fiuba-labo-de-micro-miercoles/2019-2c-proyecto-Cofimetro/README.md

Repositorio para la documentación de proyectos de
6609/8607 Laboratorio de Microcontroladores

Cabeza, Manuel 101627
Charrut, Matías -
Itzcovitz, Axel -

A decidir proyecto.
Proyecto (nombre) y breve descripción (3 párrafos)
