fiuba-labo-de-micro-miercoles/2019-2c-proyecto-Cofimetro/esquematico/kicad/report.txt

Información: Realizando copia de seguridad del archivo "C:\Users\gonza\Desktop\arduino_uno_r3_from_scratch-master\sym-lib-table" al archivo "C:\Users\gonza\Desktop\arduino_uno_r3_from_scratch-master\rescue-backup\sym-lib-table-2019-11-09-15-37-54".
Información: Realizando copia de seguridad del archivo "C:\Users\gonza\Desktop\arduino_uno_r3_from_scratch-master\Arduino_Uno_R3_From_Scratch.sch" al archivo "C:\Users\gonza\Desktop\arduino_uno_r3_from_scratch-master\rescue-backup\Arduino_Uno_R3_From_Scratch-2019-11-09-15-37-54.sch".
Información: Realizando copia de seguridad del archivo "C:\Users\gonza\Desktop\arduino_uno_r3_from_scratch-master\Voltage_Regulator.sch" al archivo "C:\Users\gonza\Desktop\arduino_uno_r3_from_scratch-master\rescue-backup\Voltage_Regulator-2019-11-09-15-37-54.sch".
Información: Realizando copia de seguridad del archivo "C:\Users\gonza\Desktop\arduino_uno_r3_from_scratch-master\voltage_management.sch" al archivo "C:\Users\gonza\Desktop\arduino_uno_r3_from_scratch-master\rescue-backup\voltage_management-2019-11-09-15-37-54.sch".
Información: Realizando copia de seguridad del archivo "C:\Users\gonza\Desktop\arduino_uno_r3_from_scratch-master\Pin_13_LED.sch" al archivo "C:\Users\gonza\Desktop\arduino_uno_r3_from_scratch-master\rescue-backup\Pin_13_LED-2019-11-09-15-37-54.sch".
Información: Realizando copia de seguridad del archivo "C:\Users\gonza\Desktop\arduino_uno_r3_from_scratch-master\USB_Interface.sch" al archivo "C:\Users\gonza\Desktop\arduino_uno_r3_from_scratch-master\rescue-backup\USB_Interface-2019-11-09-15-37-54.sch".
Información: Realizando copia de seguridad del archivo "C:\Users\gonza\Desktop\arduino_uno_r3_from_scratch-master\ATMEGA16U2.sch" al archivo "C:\Users\gonza\Desktop\arduino_uno_r3_from_scratch-master\rescue-backup\ATMEGA16U2-2019-11-09-15-37-54.sch".
Información: Realizando copia de seguridad del archivo "C:\Users\gonza\Desktop\arduino_uno_r3_from_scratch-master\Headers.sch" al archivo "C:\Users\gonza\Desktop\arduino_uno_r3_from_scratch-master\rescue-backup\Headers-2019-11-09-15-37-54.sch".
Información: Realizando copia de seguridad del archivo "C:\Users\gonza\Desktop\arduino_uno_r3_from_scratch-master\ATMEGA328P.sch" al archivo "C:\Users\gonza\Desktop\arduino_uno_r3_from_scratch-master\rescue-backup\ATMEGA328P-2019-11-09-15-37-54.sch".
Información: Realizando copia de seguridad del archivo "C:\Users\gonza\Desktop\arduino_uno_r3_from_scratch-master\Arduino_Uno_R3_From_Scratch.pro" al archivo "C:\Users\gonza\Desktop\arduino_uno_r3_from_scratch-master\rescue-backup\Arduino_Uno_R3_From_Scratch-2019-11-09-15-37-54.pro".
Información: Realizando copia de seguridad del archivo "C:\Users\gonza\Desktop\arduino_uno_r3_from_scratch-master\Arduino_Uno_R3_From_Scratch-cache.lib" al archivo "C:\Users\gonza\Desktop\arduino_uno_r3_from_scratch-master\rescue-backup\Arduino_Uno_R3_From_Scratch-cache-2019-11-09-15-37-54.lib".
Información: Realizando copia de seguridad del archivo "C:\Users\gonza\Desktop\arduino_uno_r3_from_scratch-master\Arduino_Uno_R3_From_Scratch-rescue.lib" al archivo "C:\Users\gonza\Desktop\arduino_uno_r3_from_scratch-master\rescue-backup\Arduino_Uno_R3_From_Scratch-rescue-2019-11-09-15-37-54.lib".
Información: Realizando copia de seguridad del archivo "C:\Users\gonza\Desktop\arduino_uno_r3_from_scratch-master\Arduino_Uno_R3_From_Scratch-rescue.dcm" al archivo "C:\Users\gonza\Desktop\arduino_uno_r3_from_scratch-master\rescue-backup\Arduino_Uno_R3_From_Scratch-rescue-2019-11-09-15-37-54.dcm".
Información: Añadiendo la librería "Arduino_Uno_R3_From_Scratch-rescue", archivo "${KIPRJMOD}/Arduino_Uno_R3_From_Scratch-rescue.lib" a la tabla de librerías de símbolos del projecto.
Información: Añadiendo la librería "Arduino_Uno_R3_From_Scratch", archivo "${KIPRJMOD}/Arduino_Uno_R3_From_Scratch.lib" a la tabla de librerías de símbolos del projecto.
Información: Añadiendo la librería "MFN_Atmel", archivo "${KIPRJMOD}/MFN_Atmel.lib" a la tabla de librerías de símbolos del projecto.
Información: Añadiendo la librería "MFN_STMicro", archivo "${KIPRJMOD}/MFN_STMicro.lib" a la tabla de librerías de símbolos del projecto.
El símbolo "D" está ligado a la librería de símbolos "Device".
El símbolo "CP" está ligado a la librería de símbolos "Device".
El símbolo "C" está ligado a la librería de símbolos "Device".
El símbolo "BARREL_JACK" está ligado a la librería de símbolos "Arduino_Uno_R3_From_Scratch-rescue".
El símbolo "CP" está ligado a la librería de símbolos "Device".
El símbolo "R" está ligado a la librería de símbolos "Device".
El símbolo "LED" está ligado a la librería de símbolos "Arduino_Uno_R3_From_Scratch-rescue".
El símbolo "Vin" está ligado a la librería de símbolos "Arduino_Uno_R3_From_Scratch".
El símbolo "5V_LDO" está ligado a la librería de símbolos "Arduino_Uno_R3_From_Scratch".
El símbolo "5V_LDO" está ligado a la librería de símbolos "Arduino_Uno_R3_From_Scratch".
El símbolo "GND" está ligado a la librería de símbolos "power".
El símbolo "LD1117S50TR" está ligado a la librería de símbolos "Arduino_Uno_R3_From_Scratch-rescue".
El símbolo "GND" está ligado a la librería de símbolos "power".
El símbolo "GND" está ligado a la librería de símbolos "power".
El símbolo "GND" está ligado a la librería de símbolos "power".
El símbolo "GND" está ligado a la librería de símbolos "power".
El símbolo "GND" está ligado a la librería de símbolos "power".
El símbolo "R" está ligado a la librería de símbolos "Device".
El símbolo "Q_PMOS_GSD" está ligado a la librería de símbolos "Device".
El símbolo "LM358" está ligado a la librería de símbolos "Arduino_Uno_R3_From_Scratch-rescue".
El símbolo "GND" está ligado a la librería de símbolos "power".
El símbolo "GND-RESCUE-Arduino_Uno_R3_From_Scratch" está ligado a la librería de símbolos "Arduino_Uno_R3_From_Scratch-rescue".
El símbolo "USBVCC" está ligado a la librería de símbolos "Arduino_Uno_R3_From_Scratch".
El símbolo "LP2985LV" está ligado a la librería de símbolos "Arduino_Uno_R3_From_Scratch-rescue".
El símbolo "C" está ligado a la librería de símbolos "Device".
El símbolo "C" está ligado a la librería de símbolos "Device".
El símbolo "R" está ligado a la librería de símbolos "Device".
El símbolo "C" está ligado a la librería de símbolos "Device".
El símbolo "3V3_LDO" está ligado a la librería de símbolos "Arduino_Uno_R3_From_Scratch".
El símbolo "5V_LDO" está ligado a la librería de símbolos "Arduino_Uno_R3_From_Scratch".
El símbolo "5V_LDO" está ligado a la librería de símbolos "Arduino_Uno_R3_From_Scratch".
El símbolo "Vin" está ligado a la librería de símbolos "Arduino_Uno_R3_From_Scratch".
El símbolo "3V3_LDO" está ligado a la librería de símbolos "Arduino_Uno_R3_From_Scratch".
El símbolo "GND" está ligado a la librería de símbolos "power".
El símbolo "GND" está ligado a la librería de símbolos "power".
El símbolo "GND" está ligado a la librería de símbolos "power".
El símbolo "GND" está ligado a la librería de símbolos "power".
El símbolo "GND" está ligado a la librería de símbolos "power".
El símbolo "LM358" está ligado a la librería de símbolos "Arduino_Uno_R3_From_Scratch-rescue".
El símbolo "LED" está ligado a la librería de símbolos "Arduino_Uno_R3_From_Scratch-rescue".
El símbolo "R" está ligado a la librería de símbolos "Device".
El símbolo "5V_LDO" está ligado a la librería de símbolos "Arduino_Uno_R3_From_Scratch".
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
El símbolo "C" está ligado a la librería de símbolos "Device".
El símbolo "R" está ligado a la librería de símbolos "Device".
El símbolo "R" está ligado a la librería de símbolos "Device".
El símbolo "R" está ligado a la librería de símbolos "Device".
El símbolo "C" está ligado a la librería de símbolos "Device".
El símbolo "R" está ligado a la librería de símbolos "Device".
El símbolo "GND" está ligado a la librería de símbolos "power".
El símbolo "GND" está ligado a la librería de símbolos "power".
El símbolo "GND" está ligado a la librería de símbolos "power".
El símbolo "GND" está ligado a la librería de símbolos "power".
El símbolo "GND" está ligado a la librería de símbolos "power".
Información: ¡Se ha completado el mapeado de la tabla de librerías de símbolos!
