fiuba-labo-de-micro-miercoles/2019-2c-proyecto-Cofimetro/doc/informe/Informe_Coff.pdf

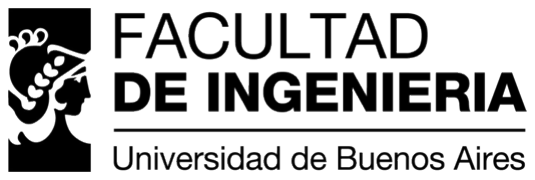
[picture p1: figure]

## Laboratorio de Microcomputadoras - 86.09

# Cofímetro

Profesor: | Ing. Guillermo Campiglio
Cuatrimestre/Año: | 2 o/2019
Turno de las clases prácticas | Miércoles 19-22 hs
Jefe de trabajos prácticos: | Ricardo Arias
Docente guía: | Ricardo Arias
Autores | Seguimiento del proyecto
Nombre | Apellido | Padron
Manuel | Cabeza | 101627
Axel | Itzcovitz | 100742
Matías | Charrut | 101137

### Observaciones:

Fecha de aprobación | Firma J.T.P

### Coloquio Nota final Firma profesor

# Índice

1. Objetivos | 1
2. Descripción del proyecto | 1
3. Diagrama de bloques | 1
4. Circuito esquemático | 1
5. Listado de componentes | 2
6. Software | 4
7. Resultados | 7
8. Conclusiones | 8
9. Apéndice I (Circuito Completo) | 8
10.Apéndice II (Código) | 18
11.Apéndice III: Presupuesto del proyecto | 35

# 1. Objetivos

El objetivo del proyecto es presentar en un display la tensión, corriente y desfasaje de un dispositivo conectado a la linea.

# 2. Descripción del proyecto

El proyecto consiste en un bloque medidor, que se encarga de obtener la información de tensión y corriente del circuito conectado a la tensión de línea, así como de adaptar estos valores de tal forma de poder ser procesados por el microcontrolador. Con esta información recibida, este último irá recolectando los valores de tensión y corriente para obtener un valor RMS de cada uno, así como también analiza cada una de las señales por medio de los muestreos adaptados que se le ingresan para calcular el desfasaje que hay entre ambas señales, para así obtener el cos(ϕ) del dispositivo. Luego, se imprimen los valores obtenidos (tensión, corriente y cos(ϕ)) utilizando un display LCD.

# 3. Diagrama de bloques

Figura 1: Diagrama de bloques.

El circuito funciona a partir de la tensión de linea para medir la corriente, tensión y el desfasaje. La medición de corriente se realiza mediante el sensor ASC-712 y la de tensión mediante un circuito realizado especialmente. El desfasaje se obtiene haciendo uso del comparador interno del microcontrolador y de un comparador externo. Estos tres parámetros son dispuestos en el display.

# 4. Circuito esquemático

El circuito completo se encuentra en el apéndice I. En esta sección se describe el circuito realizado para la medición de tensión y el sensor utilizado para la medición de corriente (ACS-712).

## 4.1. Medición de tensión

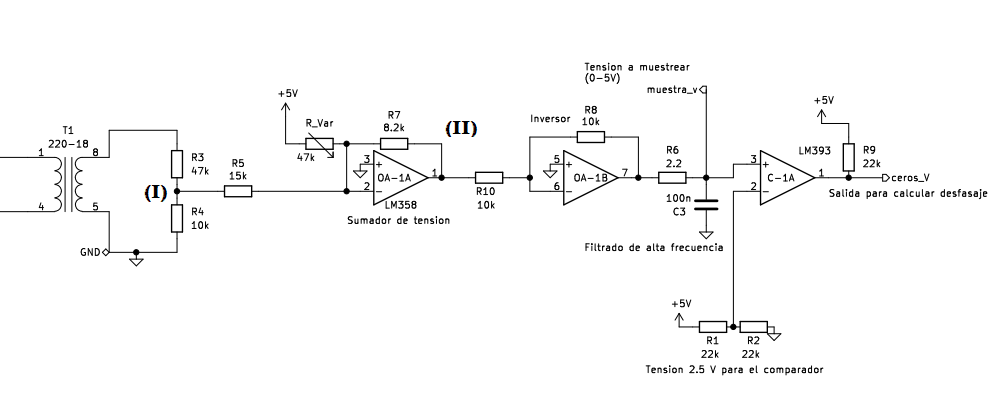
[picture p2: figure]

Figura 2: Esquema del circuito para medir tensión.

El circuito busca obtener una muestra de tensión proporcional a la de entrada que tome valores entre 0 y 5 V y una señal cuadrada que tome valores ’1’ cuando la entrada se encuentra en el semiciclo positivo y ’0’ cuando está en el semiciclo negativo. El mismo se conecta en paralelo con el dispositivo al cual se le va a medir la corriente.
Para esto se comienza con un transformador que baja el valor eficaz de la señal en un factor de aproximadamente 12.22. Esa señal pasa por un divisor resistivo para que la entrada al sumador oscile con un valor pico de 2.5 V (nodo I). La otra entrada del sumador proviene de los 5 V. A partir de los valores de resistencias R5
- R7 se modifica el preset de 47 k para obtener en el nodo II una señal que oscila alrededor de 2,5 V con un valor pico de aproximadamente 2,5 V a una entrada de 220 Vef . Esta señal pasa por un inversor para obtener la señal que se busca entre 0 y 5 V, esa pasa por un filtro RC de una alta frecuencia de corte para disminuir el ruido. A la salida del filtro se toma la señal muestra_v que va al ADC del microcontrolador. La misma va además al terminal inversor del comparador, que tiene su terminal positivo conectado a una señal continua de 2,5 V. Así a la salida del comparador se tiene la señal ceros_v que se utiliza para calcular el desfasaje. A la salida del comparador se utilizó una resistencia de Pull-Up.
Así se obtiene una señal en muestra_v cuyo valor eficaz se relaciona con el valor eficaz de la señal de entrada de forma lineal a través de la constante 91,3 (la obtención de la constante de proporcionalidad fue de forma experimental.).

## 4.2. Medición de corriente

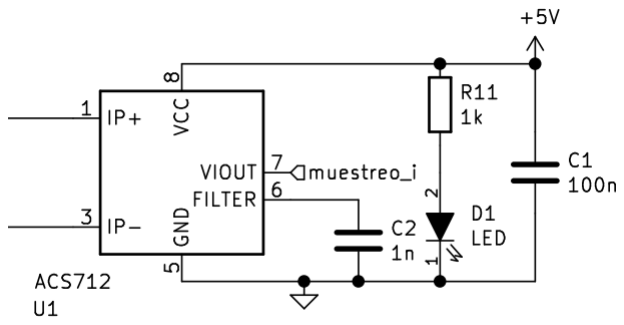
[picture p3: figure]

Figura 3: Esquema del circuito para medir corriente.

Para la medición de corriente se utilizó el circuito de la figura anterior conectado en serie con el vivo de la tensión de línea (ver Anexo I), el mismo asegura una variación lineal de tensión de salida según la corriente de entrada dada por la siguiente formula en el terminal muestreo_i, siempre que el valor de la corriente pico sea menor a 5A.

### VOUT = 2, 5V + I 0, 2

V
A
Como se alimenta con VCC = 5 V, la señal de salida varía entre 0,5 y 5 V. Ésta se conecta con el terminal del ADC del microcontrolador.

# 5. Listado de componentes

### Display LCD 16x2

### Sensor de efecto Hall ACS712 ± 5A

### Comparador LM393

### Arduino UNO

### Amplificador Operacional LM358

### Transformador 220V-18V

### Tomacorriente 220V

### Enchufe 220V

### 2 Presets 100 KΩ

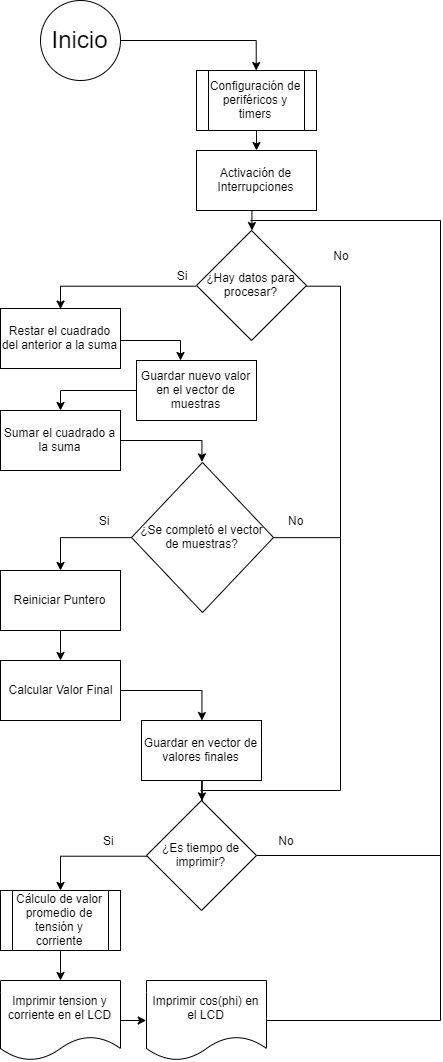
[picture p4: figure]

### Figura 4: Diagrama de flujo del programa principal

# 6. Software

El programa principal comienza con la configuración del LCD, el ADC, el timer0, el timer1 y las interrupciones. Luego, comienza el ciclo infinito del main, el cual verifica todo el tiempo si hay datos para procesar, además de vigilar si es momento de imprimir datos en el LCD. Son cuatro las distintas interrupciones del programa: el

### overflow del timer0, la cual enciende la conversión del ADC¹

, la producida cuando el ADC termina de convertir, y las de cambio de estado en el pin D5 y en el comparador. Tanto la medición de tensión como la de corriente se realizan cada 39 µs , de manera tal que se muestreen 256 veces cada una en cada ciclo (50 Hz).

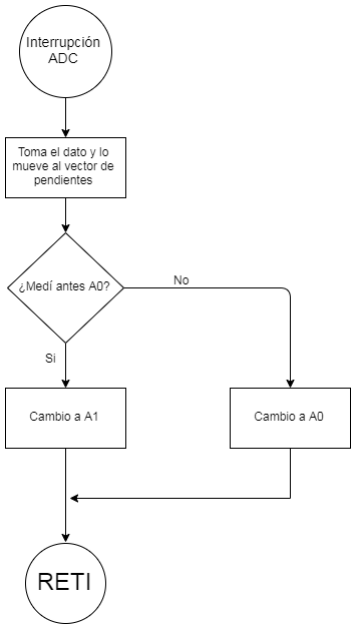
[picture p5: figure]

### Figura 5: Diagrama de flujo de la interrupción por ADC

1El timer0 también suma al contador que maneja la impresión, lo cual está ajustado para que imprima cada aproximadamente 1 segundo.

### Figura 6: Diagrama de flujo de la interrupción por Timer 0

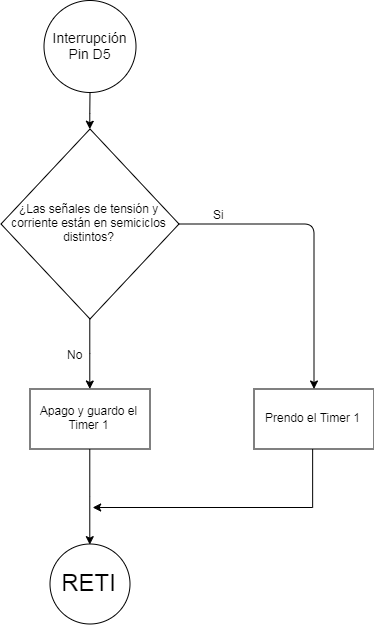
[picture p6: figure]
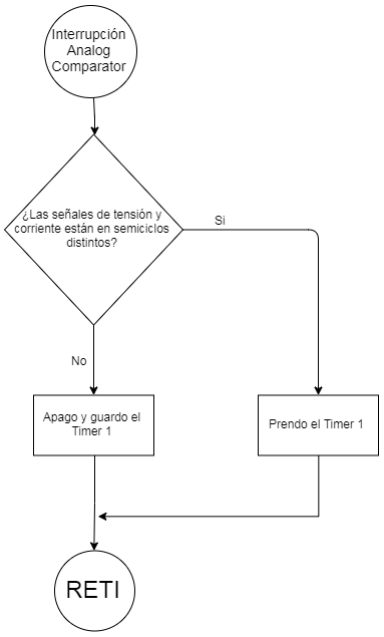
[picture p7: figure]

(a) Interrupción por el pin D5 | (b) Interrupción por el comparador analógico

### Figura 7: Diagramas de flujo de las interrupciones para el desfasaje

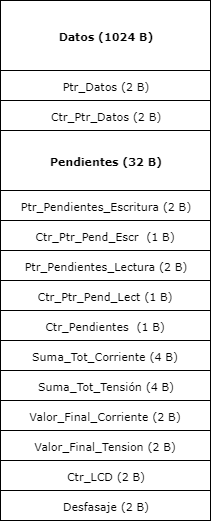
[picture p8: figure]

### Figura 8: Mapa de Memoria RAM

## 6.1. Medición de tensión y corriente

La tensión se mide por el pin A0 y la corriente por el pin A1. El proceso de medición es similar en ambos casos. Dado que el ADC es de 10 bits, a partir de lo que se mida se obtendrá un valor entre 0 y 1023. Cada vez que se mida, la interrupción del ADC guardará el valor en un vector de pendientes (cuando se llena comienza a pisar valores) y suma a un contador. El programa principal vigila este contador y cuando detecta que hay un valor pendiente, lo procesa: calcula el cuadrado del valor anterior a éste (es decir, el valor que se guardó hace 256 muestras) y se lo resta a la suma total de los cuadrados. Después, guarda el valor nuevo en el vector, le calcula el cuadrado y se lo suma al total. Cuando detecta que se llenó el vector (es decir, que llegó a la posición
256) reinicia el puntero del vector (es decir, vuelve al principio) y calcula el valor final RMS de la tensión (o la

### corriente), de modo que

### XRMS =

sP256
i=1 x

2
i
N

Este valor es guardado en un vector con los últimos 32 calculados para luego ser promediado al momento de imprimir, de modo que se pueda reducir el ruido introducido al momento de la medición. Para la impresión, este valor se usa para entrar en la tabla correspondiente (tensión o corriente), la cual lo convierte al valor real que va a ser impreso.

## 6.2. Medición de desfasaje

Para la medición del desfasaje, se busca obtener la diferencia de tiempo entre el cruce por cero de tensión y el cruce por cero de corriente. Para ello, primeramente se obtiene una señal cuadrada de cada una, tal que la misma valga ’1’ lógico para cuando se encuentra en el semiciclo positivo, y ’0’ lógico para cuando se encuentra en el semiciclo negativo. En el caso de la tensión, esta señal cuadrada valdrá ’1’ para los valores de tensión positivos, mientras que para la corriente, dado que la señal que sale del ACS712 se encuentra montada sobre una tensión continua de 2.5V, la señal valdrá ’1’ para valores de tensión mayores a esta continua sobre la que está montada. Para la obtención de la señal cuadrada de tensión, se utiliza el comparador LM393, el cual compara la señal de tensión con 2.5V, dado que la señal que obtenemos de la línea es amplificada para luego agregarle la continua de comparación, obteniendo la salida en el pin digital 5 (PD5), mientras que para la señal cuadrada de corriente se utiliza el comparador interno analógico del microcontrolador, realizando también la comparación con 2.5V, obteniendo la salida en el analog-comparator-output (ACO). Cada vez que cambia el pin 5 o la salida del comparador del microcontrolador salta una interrupción, la cual realiza una XOR entre los dos valores. Si los dos son un ’1’ o los dos son un ’0’, se apaga el timer1 y se guarda su valor. Si los valores son diferentes, se reinicia el timer1 y se prende. El preescaler se configuró de manera que sea posible medir 10ms, que es el máximo desfasaje posible que puede existir en una señal de línea. Para la impresión, este valor se usa para entrar en una tabla, la cual lo convierte al valor real que va a ser impreso.

# 7. Resultados

Una vez ensamblados hardware y software, los resultados iniciales fueron muy desalentadores, dado que no se conseguía estabilizar los valores a obtener, además de que los valores obtenidos no eran los correctos (según los valores de tensión de línea y corriente medidos con un multímetro ). Así, se encontraron múltiples diferencias entre nuestra estimación de lo que sería el circuito con lo que finalmente era, como que la tensión continua del ACS712 no era exactamente 2.5V o que la frecuencia de la tensión de línea no coincidía con nuestra tensión de muestreo del microcontrolador. Por lo tanto, se debió realizar una calibración del circuito, para así ajustar nuestros cálculos iniciales a los valores reales de cada componente.
La calibración se realizó tomando muestras de los valores a la entrada y la salida del circuito y, dado que la relación entre los mismos varía como una raíz cuadrada al ser valores eficaces, se elevaron al cuadrado los resultados para levarla a una relación lineal y poder hacer cuadrados mínimos. Así se obtuvo una calibración final que lleva a una mejor aproximación de las mediciones que la original.
Para poder medir el cos(ϕ) se debió realizar un circuito aparte que genere un desfasaje entre dos señales, debido a que para medir un cos(ϕ) distinto de 1 se debía utilizar un instrumento altamente inductivo, como un motor, el cual resultaba impráctico para realizar la medición. Para el mismo se utilizó el circuito en la figura 9, con el cual utilizando un preset entre la entrada V1 y el borne positivo del operacional se pudo regular un cos(ϕ) entre 0 y 1, para así verificar el correcto funcionamiento del medidor a lo largo de todos los valores.

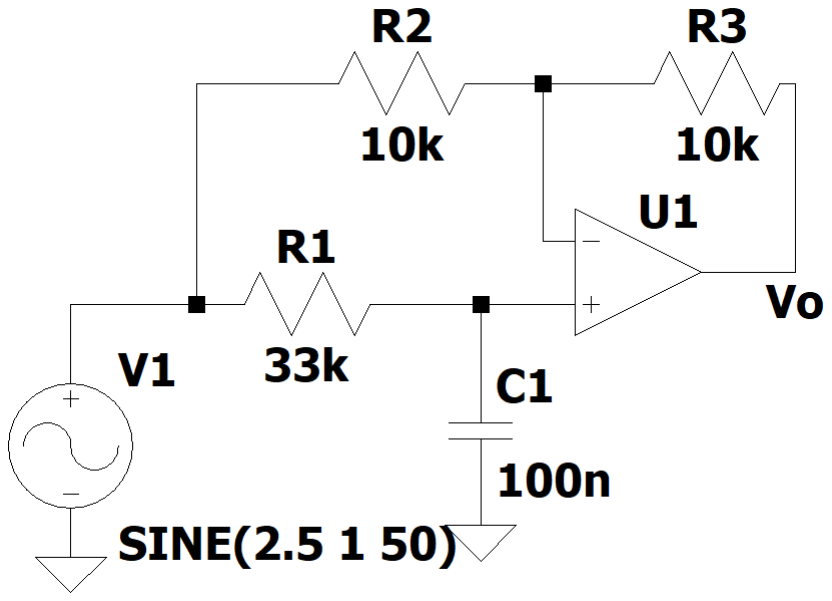
[picture p9: figure]

### Figura 9: Circuito utilizado para la medición del cos(ϕ)

Sobre la precisión final del las mediciones, en el caso de la tensión se debió mapear un valor eficaz a la entrada que iba desde 0 V hasta como máximo 250 V a una variación de valor eficaz a la salida de 0.56 V (como máximo). Debido a esto la incerteza final de las mediciones no se pudo reducir demasiado y de los 10 bits que se utilizaron para realizar la medición, es decir una tabla de 1024 posiciones, solo fueron utilizables 114 entradas. Algo análogo sucedió para la corriente, donde el valor eficaz máximo obtenible limitado por el sensor es de 3,57 A. A la salida también se obtiene una señal con una variación de valor eficaz menor a 0,56 V reduciendo el número efectivo de entradas a las tablas de mediciones y empeorando la incerteza de las mediciones.

# 8. Conclusiones

Una de las principales conclusiones que se obtuvieron a partir de la realización del proyecto es la importancia de la correcta obtención de los valores con los que se realizan los cálculos previos a las mediciones y la correcta caracterización de los periféricos, ya que por ejemplo, según los cálculos del amplificador para la tensión, la continua que agregaba era de 2,5 V, pero la que se agregaba realmente era de 2,4 V, y esto alteraba las mediciones. Estas diferencias entre la teoría y la práctica llevaron a que se obtuvieran serias diferencias entre los valores que debíamos obtener y los obtenidos, dada la sensibilidad que manejaba este circuito con respecto a estos valores.
Por último, la experiencia de realizar un proyecto cuya función principal fuese la medición resultó un tanto conflictiva, debido a la cantidad de componentes que requiere el mismo, aumentando así la posibilidad de obtener mediciones erróneas o inestables ante la pequeña falla de alguno de estos, como un pequeño desafloje de los pines o los cables, un pequeño desajuste en la frecuencia de muestreo, o una ligera diferencia entre una constante teórica y real.

# 9. Apéndice I (Circuito Completo)

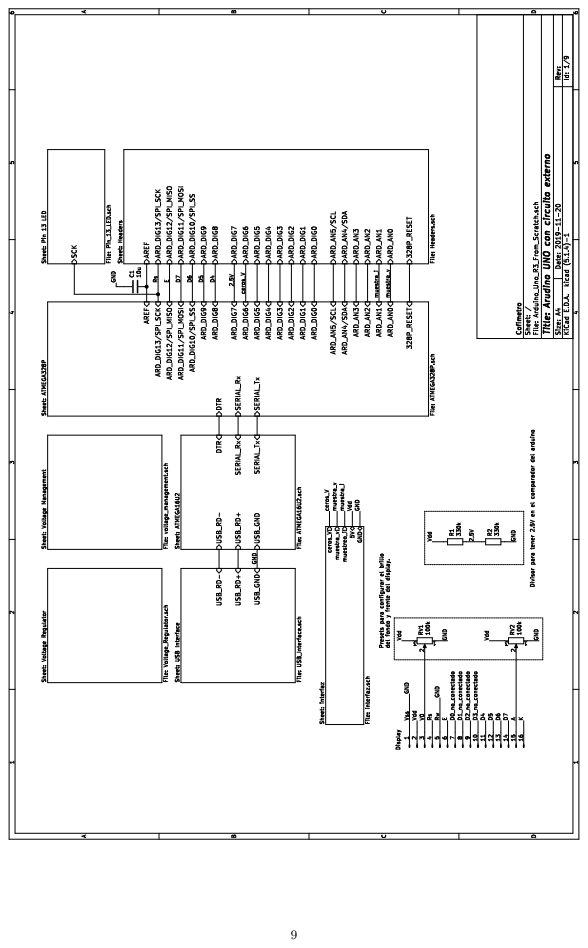
[picture p10: page 11]

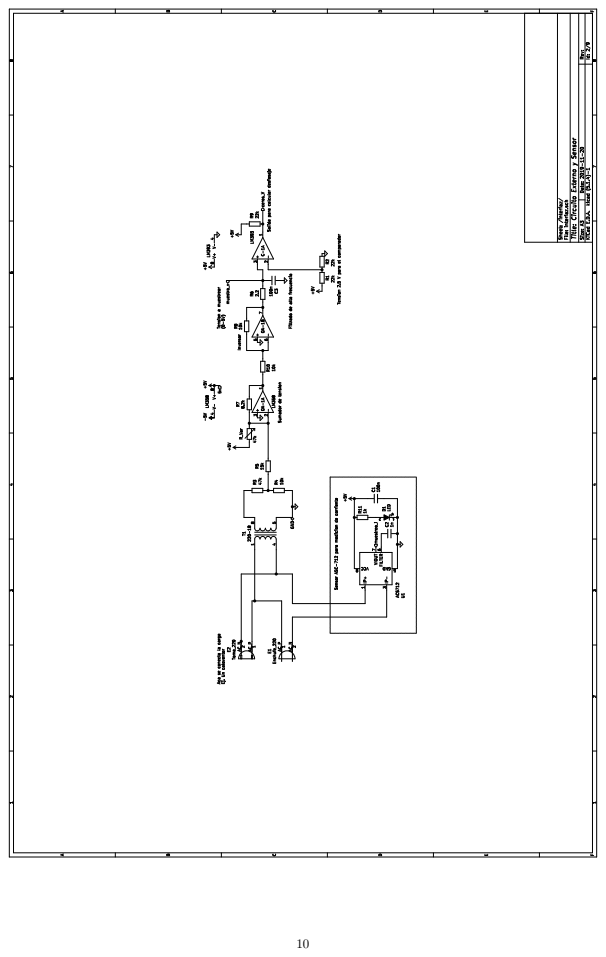
[picture p11: page 12]

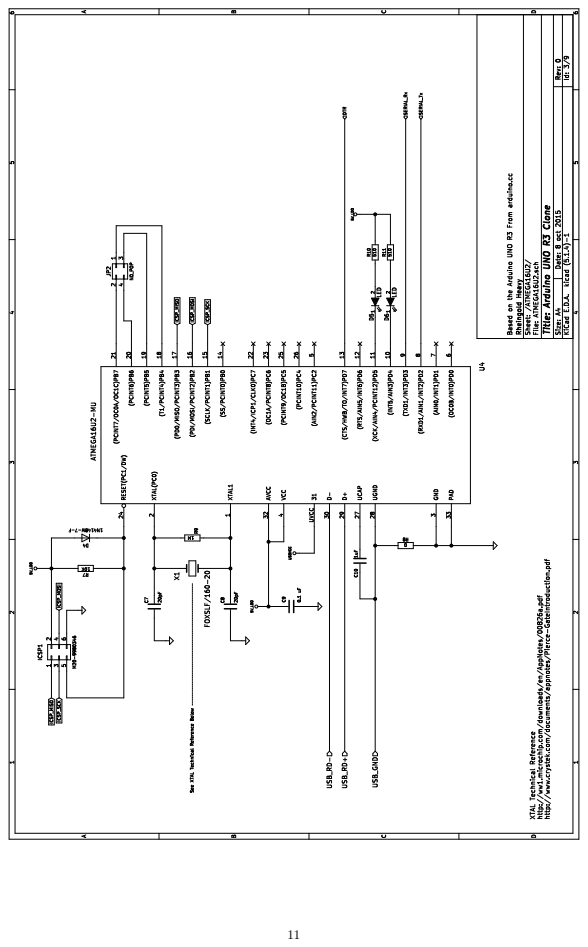
[picture p12: page 13]

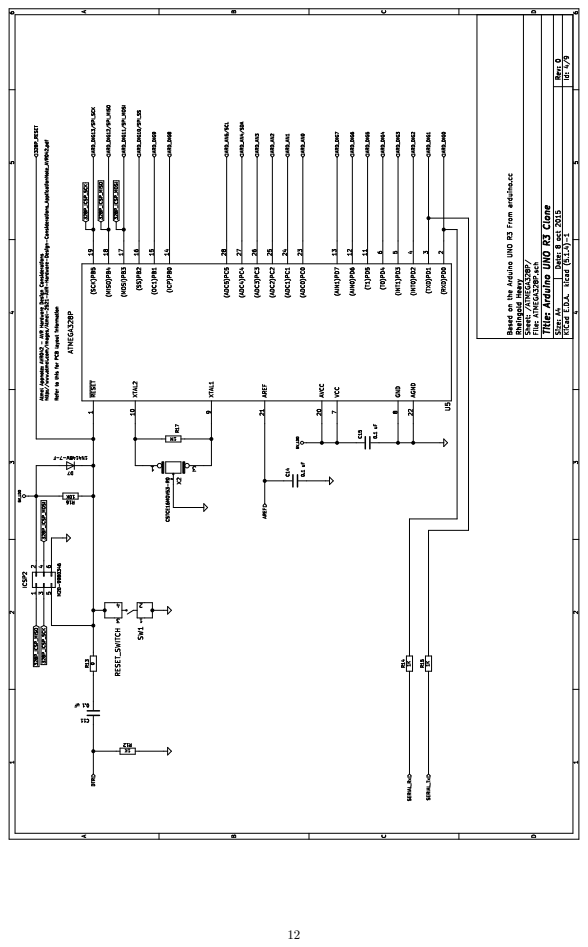
[picture p13: page 14]

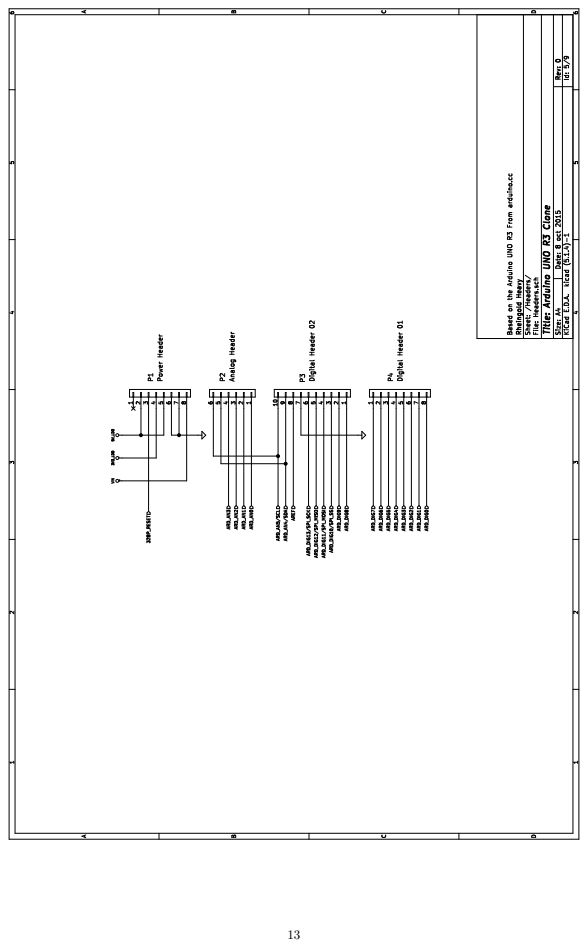
[picture p14: page 15]

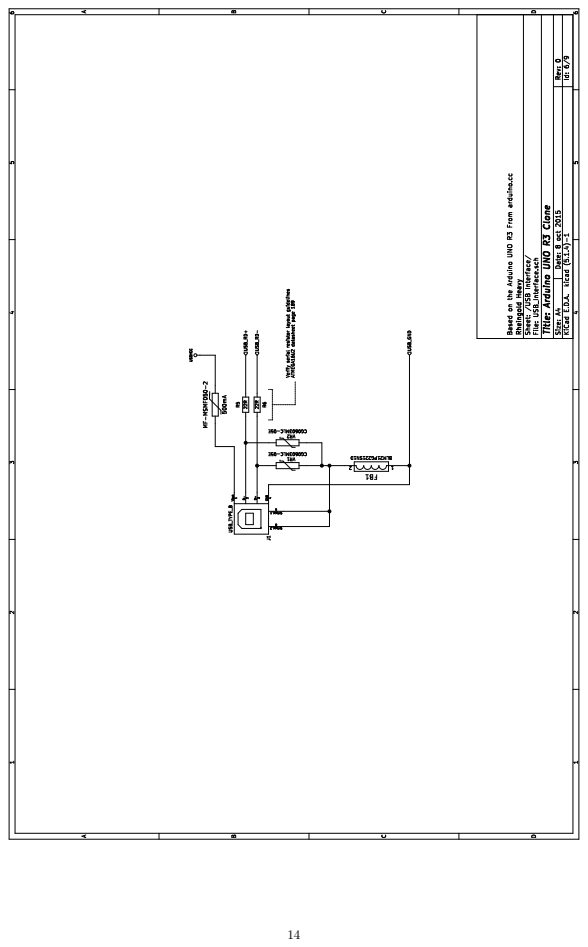
[picture p15: page 16]

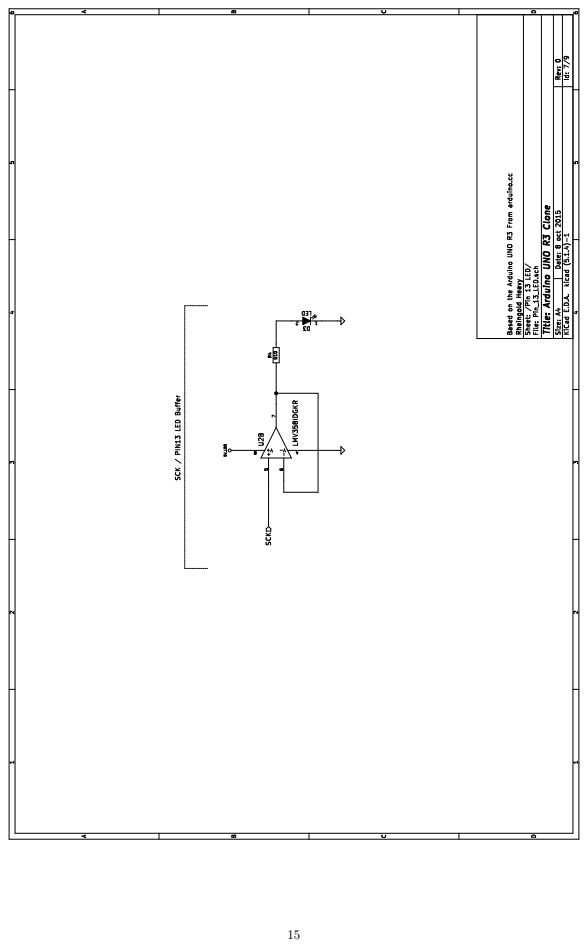
[picture p16: page 17]

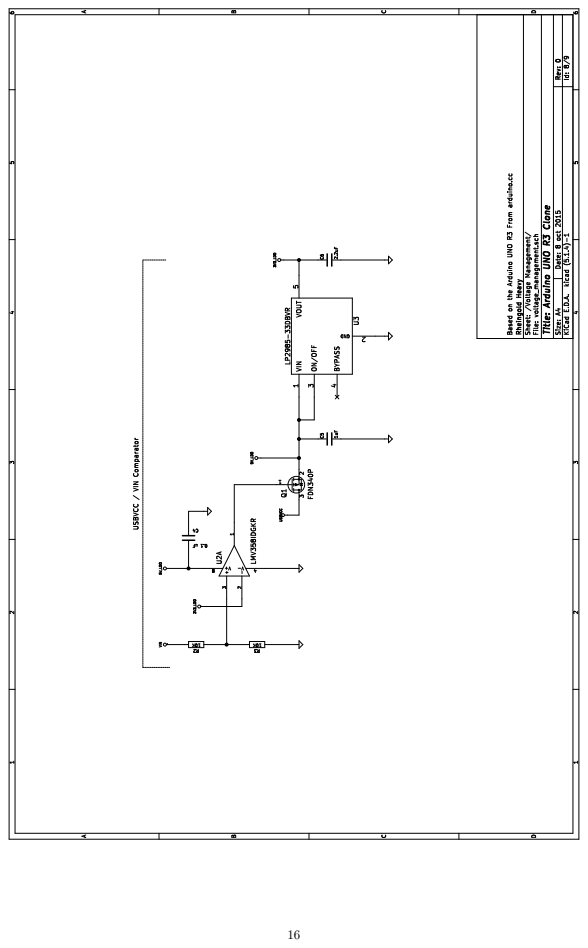
[picture p17: page 18]

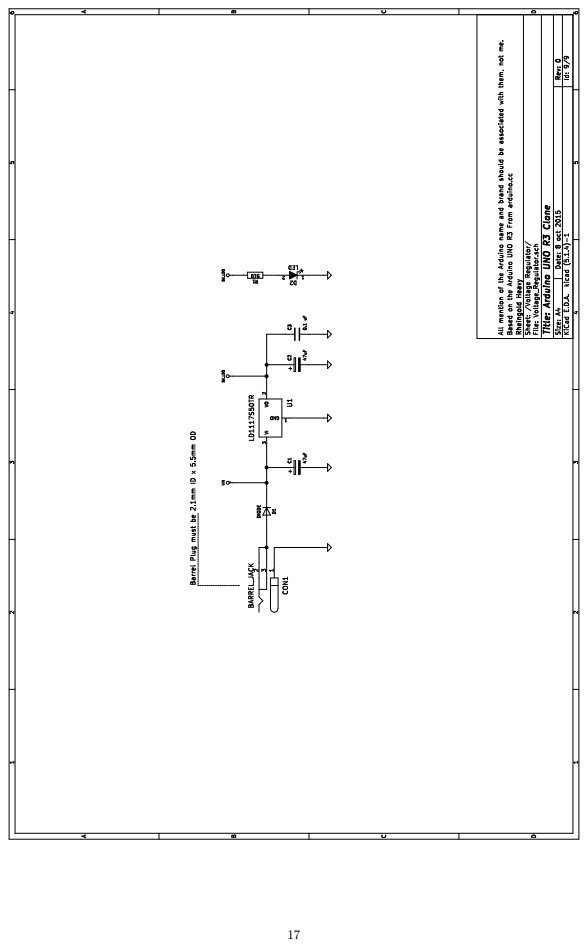
[picture p18: page 19]

# 10. Apéndice II (Código)

1 | ; f i l e : main . asm
2 | . i n cl u d e "m328pdef . i n c "
3 | ; F r e c u e n ci a 16MHz

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

20
21 | ENTER_WRITE_ROM:
22 | MOVE_TO NEXT_LINE
23 | LDI R21 , 15
24 | RJMP FOR_WRITE_ROM

25
26 | END_WRITE_ROM:
27 | ; te rmin a l a macro
28 | .ENDM

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

35

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

55

56
57 CTR_LCD: .BYTE 2 ; c on t ad o r de tiempo de r e f r e s c o de l c d

58
59 DESFASAJE: .BYTE 1 ; v al o r de d e s f a s a j e

60
61 | .CSEG
62 | ; v e c t o r e s de i n t e r r u p c i o n
63 | .ORG 0 x0000
64 | RJMP MAIN
65 | .ORG PCI2addr
66 | RJMP HANDLER_XOR
67 | .ORG OVF0addr
68 | RJMP HANDLER_TIMER0
69 | .ORG ADCCaddr
70 | RJMP HANDLER_ADC
71 | .ORG ACIaddr
72 | RJMP HANDLER_XOR

74 .ORG INT_VECTORS_SIZE

75

76
77 | MAIN:
78 | ; i n i c i a l i z o e l s t a c k
79 | LDI R16 , LOW(RAMEND)
80 | OUT SPL, R16
81 | LDI R16 , HIGH(RAMEND)
82 | OUT SPH, R16

83
84 | CALL CONFIGURATION_LCD
85 | CALL CONFIGURAR_ADC

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

91

92
93 | CALL INICIALIZAR_SUMAS

94
95 | CALL INICIALIZAR_PTR_DATOS

96
97 | CALL INICIALIZAR_PUNTERO_PENDIENTES_LECTURA

98
99 | CALL INICIALIZAR_PUNTERO_VALOR_FINAL

100
101 | CLR R16
102 | STS CTR_PENDIENTES, R16

103
104 | ; c o n fi g u r o d e s f a s a j e
105 | CALL CONFIGURAR_DESFASAJE

106
107 | ; lim pi o l c d e imprimo e l t e x t o (V, I , c o s ( phi ) )
108 | CALL CLEAN
109 | CALL TEXTO_LCD

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

113

114

115
116 | HERE: ; c i c l o i n f i n i t o de v e r i f i c a r s i hay p e n di e n t e s para p r o c e s a r e imp rimi r
117 | LDS R16 , CTR_PENDIENTES
118 | CLR R0
119 | CPSE R16 , R0
120 | CALL PROCESAR
121 | LDS R16 , CTR_LCD + 1
122 | SBRC R16 , 7
123 | CALL IMPRIMIR_TODO
124 | RJMP HERE

125

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

137

138
139 | ; t e x t o para imp rimi r .
140 | TEX_TENSION: .DB "V=", ’ \ 0 ’
141 | TEX_CORRIENTE: .DB " I =", ’ \ 0 ’
142 | TEX_COSFI: .DB " c o s ( phi ) =", ’ \ 0 ’

### codigo/main.asm

[U+FFFD] 1 | ; f i l e : r aiz_cu ad r ad a . asm

2
3 . i n cl u d e "m328pdef . i n c "

5 | .DEF CUADRADO_4toBYTE = R2
6 | .DEF CUADRADO_3erBYTE = R3
7 | .DEF CUADRADO_2doBYTE = R4
8 | .DEF CUADRADO_1erBYTE = R5
9 | .DEF RESTO_4 = R6
10 | .DEF RESTO_3 = R7
11 | .DEF RESTO_2 = R8
12 | .DEF RESTO_1 = R9
13 | .DEF CONT_RL = R10
14 | .DEF CONT_ITERACIONES = R11
15 | .DEF DIVIS_4 = R12
16 | .DEF DIVIS_3 = R13
17 | .DEF DIVIS_2 = R14
18 | .DEF DIVIS_1 = R15
19 | .DEF TEMP = R16
20 | .DEF INIT_CUADRADO_4toBYTE = R18
21 | .DEF INIT_CUADRADO_3erBYTE = R19
22 | .DEF INIT_CUADRADO_2doBYTE = R20
23 | .DEF INIT_CUADRADO_1erBYTE = R21
24 | .DEF RESUL_4 = R22
25 | .DEF RESUL_3 = R23
26 | .DEF RESUL_2 = R24
27 | .DEF RESUL_1 = R25
28 | .DEF DIVID_4 = R22
29 | .DEF DIVID_3 = R23
30 | .DEF DIVID_2 = R24
31 | .DEF DIVID_1 = R25

32

33
34 | .EQU CANT_ITERACIONES = 6
35 | .EQU FALTA_RESTA_4toBYTE = 2
36 | .EQU FALTA_RESTA_3erBYTE = 1
37 | .EQU FALTA_RESTA_2doBYTE = 0

38

39
40 | ; s e l e pasan v a l o r e s de sde R5(LSB) h a s t a R2(MSB) , y d e v u el v e l a r a i z en R21 (LSB) y en R20 (MSB)
41 | RAIZ_CUADRADA:
42 | ; s e lim pi a n t od o s l o s r e g i s t r o s que s e vayan a u s a r
43 | CLR RESTO_4
44 | CLR RESTO_3
45 | CLR RESTO_2
46 | CLR RESTO_1
47 | CLR CONT_RL
48 | CLR CONT_ITERACIONES
49 | CLR DIVIS_4
50 | CLR DIVIS_3
51 | CLR DIVIS_2
52 | CLR DIVIS_1
53 | CLR TEMP
54 | CLR INIT_CUADRADO_4toBYTE
55 | CLR INIT_CUADRADO_3erBYTE
56 | CLR INIT_CUADRADO_2doBYTE
57 | CLR INIT_CUADRADO_1erBYTE
58 | CLR RESUL_4
59 | CLR RESUL_3
60 | CLR RESUL_2
61 | CLR RESUL_1
62 | CLR DIVID_4
63 | CLR DIVID_3
64 | CLR DIVID_2
65 | CLR DIVID_1
66 | LDI TEMP,CANT_ITERACIONES
67 | MOV CONT_ITERACIONES,TEMP;CARGO LA CANTIDAD DE ITERACIONES

68
69 | ; s i e l numero que s e i n g r e s a para h a c e r l a r a i z cuadrada e s 0 , di r e c t am e n t e s e d e v u el v e 0
70 | ; para e v i t a r h a c e r d i v i s i o n e s por 0 .
71 | VERIFICAR_CERO:
72 | CLR TEMP
73 | CP CUADRADO_1erBYTE, TEMP
74 | BRNE INICIALIZAR_RAIZ
75 | CP CUADRADO_2doBYTE, TEMP
76 | BRNE INICIALIZAR_RAIZ
77 | CP CUADRADO_3erBYTE, TEMP
78 | BRNE INICIALIZAR_RAIZ
79 | CP CUADRADO_4toBYTE, TEMP
80 | BRNE INICIALIZAR_RAIZ

81 | RET

82
83 | ; INICIALIZO LA SEMILLA SEGUN EL TAMAÑO DEL NUMERO QUE ENTRA
84 | INICIALIZAR_RAIZ :
85 | CLR INIT_CUADRADO_4toBYTE
86 | CLR INIT_CUADRADO_3erBYTE
87 | LDI INIT_CUADRADO_2doBYTE, 0 xFF
88 | LDI INIT_CUADRADO_1erBYTE, 0 xFF
89 | VER_4toBYTE:
90 | CLR TEMP
91 | CP CUADRADO_4toBYTE,TEMP
92 | BRNE VER_3erBYTE
93 | ANDI INIT_CUADRADO_2doBYTE, 0 xF0
94 | VER_3erBYTE:
95 | CP CUADRADO_3erBYTE,TEMP
96 | BRNE VER_2doBYTE
97 | ANDI INIT_CUADRADO_2doBYTE, 0 x0F
98 | VER_2doBYTE:
99 | CP CUADRADO_2doBYTE,TEMP
100 | BRNE VER_1erBYTE
101 | ANDI INIT_CUADRADO_1erBYTE, 0 xF0
102 | VER_1erBYTE:
103 | CP CUADRADO_1erBYTE,TEMP
104 | BRNE ITERACION_RAIZ
105 | ANDI INIT_CUADRADO_1erBYTE, 0 x0F
106 | ; [ FIN ] INICIALIZO LA SEMILLA SEGUN EL TAMAÑO DEL NUMERO QUE ENTRA

107

108
109 | ; i t e r a c i o n de newton−raphson
110 | ITERACION_RAIZ:
111 | CALL RAIZ_NR
112 | DEC CONT_ITERACIONES
113 | BRNE ITERACION_RAIZ
114 | RET

115
116 | ; e j e c u t a una i t e r a c i o n de newton−raphson
117 | RAIZ_NR:
118 | ; a
119 | MOVW DIVID_3 : DIVID_4 ,CUADRADO_3erBYTE:CUADRADO_4toBYTE
120 | MOVW DIVID_1 : DIVID_2 ,CUADRADO_1erBYTE:CUADRADO_2doBYTE
121 | ; [ FIN ] a
122 | ;X( k )
123 | MOVW DIVIS_3 : DIVIS_4 , INIT_CUADRADO_3erBYTE: INIT_CUADRADO_4toBYTE
124 | MOVW DIVIS_1 : DIVIS_2 , INIT_CUADRADO_1erBYTE:INIT_CUADRADO_2doBYTE
125 | ; [ FIN ]X( k )
126 | CALL DIVISION ; a /X( k )
127 | ;X( k ) + a/X( k )
128 | ADD INIT_CUADRADO_1erBYTE,RESUL_1
129 | ADC INIT_CUADRADO_2doBYTE,RESUL_2
130 | ADC INIT_CUADRADO_3erBYTE,RESUL_3
131 | ADC INIT_CUADRADO_4toBYTE,RESUL_4
132 | ; [ FIN ]X( k ) + a/X( k )
133 | ; (X( k ) + a/X( k ) ) /2
134 | LSR INIT_CUADRADO_4toBYTE
135 | ROR INIT_CUADRADO_3erBYTE
136 | ROR INIT_CUADRADO_2doBYTE
137 | ROR INIT_CUADRADO_1erBYTE
138 | ; [ FIN ] (X( k ) + a/X( k ) ) /2
139 | RET

140
141 | ; di vi d e mediante e l metodo de r o l i d o . r e c i b e e l di vi d e n d o de sde R25 (LSB) A R22 (MSB) y e l
| d i v i s o r
142 | ; de sde R15 (LSB) a R12 (MSB) . Devuelve e l r e s u l t a d o de sde R25 (LSB) a R22 (MSB) .
143 | DIVISION :
144 | ; LIMPIAR RESTO
145 | CLR RESTO_4
146 | CLR RESTO_3
147 | CLR RESTO_2
148 | SUB RESTO_1,RESTO_1
149 | ; LIMPIAR RESTO
150 | LDI TEMP, 3 3 ;COMENZAR LOOP CONTADOR QUE VA A HACER TANTOS ROLIDOS COMO DIGITOS HAYA
151 | MOV CONT_RL,TEMP;COMENZAR LOOP CONTADOR QUE VA A HACER TANTOS ROLIDOS COMO DIGITOS HAYA

152
153 | ROL_DIVIDENDO:
154 | ; SHIFTEAR DIVIDENDO
155 | ROL DIVID_1

156 | ROL DIVID_2
157 | ROL DIVID_3
158 | ROL DIVID_4
159 | ; [ FIN ] SHIFTEAR DIVIDENDO

160
161 | DEC CONT_RL;DECREMENTAR CONTADOR DE SHIFTEOS
162 | BRNE ROL_RESTO; S I NO SE HICIERON TODOS LOS ROLIDOS, SE PROCEDE A CONTINUAR LA DIVISION
163 | RJMP REDONDEO; S I SE HICIERON TODOS LOS ROLIDOS, SE DA POR TERMINADA LA DIVISION

164
165 | ROL_RESTO:
166 | ; SHIFTEAR RESTO
167 | ROL RESTO_1
168 | ROL RESTO_2
169 | ROL RESTO_3
170 | ROL RESTO_4
171 | ; [ FIN ] SHIFTEAR RESTO

172
173 | ;RESTO = RESTO − DIVISOR
174 | SUB RESTO_1, DIVIS_1
175 | SBC RESTO_2, DIVIS_2
176 | SBC RESTO_3, DIVIS_3
177 | SBC RESTO_4, DIVIS_4
178 | ;RESTO = RESTO − DIVISOR

179
180 | BRCC INC_RES; S I EL DIVISOR ES MENOR AL RESTO, SE MANTIENE EL RESTO COMO ESTABA Y SE
| INCREMENTA EL RESULTADO

181
182 | ; S I EL DIVISOR ES MAYOR AL RESTO, SE LO RESTITUYE A COMO ESTABA ANTES DE LA RESTA
183 | ADD RESTO_1, DIVIS_1
184 | ADC RESTO_2, DIVIS_2
185 | ADC RESTO_3, DIVIS_3
186 | ADC RESTO_4, DIVIS_4
187 | CLC;TAMBIEN SE RESTITUYE EL CARRY
188 | ; S I EL DIVISOR ES MAYOR AL RESTO, SE LO RESTITUYE A COMO ESTABA ANTES DE LA RESTA
189 | RJMP ROL_DIVIDENDO; SE VUELVE A ARRANCAR EL ROLIDO DEL DIVIDENDO

190
191 | INC_RES:
192 | SEC; SE PRENDE EL CARRY PARA SER INCLUIDO EN EL RESULTADO
193 | RJMP ROL_DIVIDENDO; SE VUELVE A ARRANCAR EL ROLIDO DEL DIVIDENDO

194
195 | ; s e f i j a s i e l r e s t o e s mayor o i g u a l a l a mitad d el d i v i s o r , y suma 1 s i e s a s i .
196 | REDONDEO:
197 | LSR DIVIS_4
198 | ROR DIVIS_3
199 | ROR DIVIS_2
200 | ROR DIVIS_1
201 | SUB DIVIS_4 ,RESTO_4
202 | BRCS SUM_1
203 | BRNE RETIRADA
204 | SUB DIVIS_3 ,RESTO_3
205 | BRCS SUM_1
206 | BRNE RETIRADA
207 | SUB DIVIS_2 ,RESTO_2
208 | BRCS SUM_1
209 | BRNE RETIRADA
210 | SUB DIVIS_1 ,RESTO_1
211 | BRSH RETIRADA
212 | SUM_1:
213 | LDI TEMP, 1
214 | ADD DIVID_1 ,TEMP
215 | CLR TEMP
216 | ADC DIVID_2 ,TEMP
217 | ADC DIVID_3 ,TEMP
218 | ADC DIVID_4 ,TEMP
219 | RETIRADA: RET

### codigo/raiz_cuadrada.asm

1 ; f i l e : p r o c e s a r . asm

2
3 . i n cl u d e "m328pdef . i n c "

4
5 .EQU CANT_PROM = 32

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

9 | LDI XH, HIGH(DATOS)
10 | LDI R16 , 1
11 | LDI R17 , 1 | ; a r r a n c a en 1 e l c on t ad o r (LSB)
12 | LDI R18 , 0 ; MSB
13 | LDI R19 , 8
14 | CLR R0
15 | FOR_INICIALIZAR_TODO:
16 | ST X+, R0
17 | LDI R16 , 1
18 | ADD R17 , R16
19 | ADC R18 , R0
20 | CPSE R18 , R19 ; cuen t o h a s t a 1024
21 | RJMP FOR_INICIALIZAR_TODO
22 | RET

23
24 | INICIALIZAR_SUMAS: ; i n i c i a l i z o l a suma de t e n si o n y c o r r i e n t e en 0
25 | CLR R7
26 | CLR R8
27 | CLR R9
28 | CLR R10
29 | CALL GUARDAR_SUMA_TENSION
30 | CALL GUARDAR_SUMA_CORRIENTE
31 | RET

32

33
34 | SUMAR_3_4_BYTES: ; SE LE PASA R7(LSB) R8 R9 Y R10 (MSB) Y R23 (LSB) R24 Y R25 (MSB)
35 | CLR R0
36 | ADD R7 , R23
37 | ADC R8 , R24
38 | ADC R9 , R25
39 | ADC R10 , R0
40 | RET

41
42 | RESTAR_4_3_BYTES: ; SE LE PASA R7(LSB) R8 R9 Y R10 (MSB) Y R23 (LSB) R24 Y R25 (MSB)
43 | CLR R0
44 | SUB R7 , R23
45 | SBC R8 , R24
46 | SBC R9 , R25
47 | SBC R10 , R0
48 | RET

49
50 | PROCESAR:
51 | ; l e o e l p e n di e n t e
52 | LDS XL, PTR_PENDIENTES_LECTURA
53 | LDS XH, PTR_PENDIENTES_LECTURA + 1
54 | LD R16 , X+
55 | LD R17 , X+
56 | STS PTR_PENDIENTES_LECTURA, XL
57 | STS PTR_PENDIENTES_LECTURA + 1 , XH

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

65
66 | ; c a l c u l o e l cuadrado d el v i e j o y guardo e l nuevo ( y guardo e l pun te r o de nuevo en ram )
67 | LDS YL, PTR_DATOS
68 | LDS YH, PTR_DATOS + 1
69 | LD R21 , Y
70 | ST Y+, R16
71 | LD R22 , Y
72 | ST Y+, R17
73 | STS PTR_DATOS, YL
74 | STS PTR_DATOS + 1 , YH
75 | CALL CUADRADO ; ll am o a cuadrado con R21 (L) y R22 (M) y me d e v u el v e R23 (L) R24 Y R25 (M)

76
77 | ; l e r e s t o a l a suma t o t a l
78 | CALL RESTAR_4_3_BYTES

79
80 | ; c a l c u l o e l cuadrado nuevo
81 | MOV R21 , R16
82 | MOV R22 , R17
83 | CALL CUADRADO

85 | ; sumo e l cuadrado nuevo
86 | CALL SUMAR_3_4_BYTES

87
88 | ; guardo l a suma de nuevo
89 | SBRS R18 , 0
90 | CALL GUARDAR_SUMA_TENSION
91 | SBRC R18 , 0
92 | CALL GUARDAR_SUMA_CORRIENTE

93

94
95 | ; sumo a l c on t ad o r d el pun te r o
96 | LDS R18 , CTR_PTR_DATOS
97 | LDS R19 , CTR_PTR_DATOS + 1 ; e l LSB ya l o h abi a c a r g ad o a n t e ri o rm e n t e
98 | LDI R16 , 1
99 | ADD R18 , R16
100 | CLR R0
101 | ADC R19 , R0

102

103
104 | ; guardo e l c on t ad o r d el pun te r o
105 | STS CTR_PTR_DATOS, R18
106 | STS CTR_PTR_DATOS + 1 , R19

107
108 | ; s i l l e g o a 512 r e i n i c i o
109 | CPI R19 , 2
110 | BREQ BRANCH_INICIALIZAR_PUNTERO_DATOS

111
112 | SEGUIR_PUNTERO_DATOS:
113 | ; decrementa l o s p e n di e n t e s .
114 | LDS R19 , CTR_PENDIENTES
115 | DEC R19
116 | STS CTR_PENDIENTES, R19

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

125
126 BRANCH_INICIALIZAR_PUNTERO_DATOS:

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

134
135 | BRANCH_INICIALIZAR_PUNTERO_PENDIENTES_LECTURA:
136 | CALL INICIALIZAR_PUNTERO_PENDIENTES_LECTURA
137 | RJMP SEGUIR_INICIALIZAR_PUNTERO_PENDIENTES_LECTURA

138

139

140

141
142 | INICIALIZAR_PUNTERO_VALOR_FINAL:
143 | LDI R16 , CANT_PROM ; c a n ti d a d de v a l o r e s para r e a l i z a r e l promedio
144 | STS CTR_PTR_VALOR_FINAL, R16
145 | LDI XL, LOW(VALOR_FINAL_TENSION)
146 | LDI XH, HIGH(VALOR_FINAL_TENSION)
147 | STS PTR_VALOR_FINAL_TENSION, XL
148 | STS PTR_VALOR_FINAL_TENSION + 1 , XH
149 | LDI XL, LOW(VALOR_FINAL_CORRIENTE)
150 | LDI XH, HIGH(VALOR_FINAL_CORRIENTE)
151 | STS PTR_VALOR_FINAL_CORRIENTE, XL
152 | STS PTR_VALOR_FINAL_CORRIENTE + 1 , XH
153 | RET

154

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

160 | STS PTR_DATOS + 1 , XH
161 | LDI R18 , 0
162 | LDI R19 , 0
163 | STS CTR_PTR_DATOS, R18
164 | STS CTR_PTR_DATOS + 1 , R19
165 | RET

166

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

176

177
178 | CARGAR_SUMA_TENSION: ; c a r g a l a suma de t e n si o n a l o s r e g i s t r o s R7 , R8 , R9 y R10
179 | LDI XL, LOW(SUMA_TOTAL_TENSION)
180 | LDI XH, HIGH(SUMA_TOTAL_TENSION)
181 | LD R7 , X+
182 | LD R8 , X+
183 | LD R9 , X+
184 | LD R10 , X+
185 | RET

186
187 | GUARDAR_SUMA_TENSION: ; guarda l a suma de t e n si o n de sde l o s r e g i s t r o s R7 , R8 , R9 y R10
188 | LDI XL, LOW(SUMA_TOTAL_TENSION)
189 | LDI XH, HIGH(SUMA_TOTAL_TENSION)
190 | ST X+, R7
191 | ST X+, R8
192 | ST X+, R9
193 | ST X+, R10
194 | RET

195
196 | CARGAR_SUMA_CORRIENTE: ; c a r g a l a suma de c o r r i e n t e a l o s r e g i s t r o s R7 , R8 , R9 y R10
197 | LDI XL, LOW(SUMA_TOTAL_CORRIENTE)
198 | LDI XH, HIGH(SUMA_TOTAL_CORRIENTE)
199 | LD R7 , X+
200 | LD R8 , X+
201 | LD R9 , X+
202 | LD R10 , X+
203 | RET

204
205 | GUARDAR_SUMA_CORRIENTE: ; guarda l a suma de c o r r i e n t e de sde l o s r e g i s t r o s R7 , R8 , R9 y R10
206 | LDI XL, LOW(SUMA_TOTAL_CORRIENTE)
207 | LDI XH, HIGH(SUMA_TOTAL_CORRIENTE)
208 | ST X+, R7
209 | ST X+, R8
210 | ST X+, R9
211 | ST X+, R10
212 | RET

213

214
215 | CALCULAR_VALOR_FINAL_TENSION: ; p rime r o hace l a r a i z cuadrada y de spue s di vi d e por 16 ( s h i f t
| de rech o 4 v e c e s )
216 | LDI XL, LOW(SUMA_TOTAL_TENSION)
217 | LDI XH, HIGH(SUMA_TOTAL_TENSION)
218 | LD R5 , X+
219 | LD R4 , X+
220 | LD R3 , X+
221 | LD R2 , X+
222 | CALL RAIZ_CUADRADA; toma en R5(L) h a s t a R2 (M) ( o j o ! a l r e v e s que todo e l programa )
223 | ; d e v u el v e de sde R21 (L) a R20 (M)
224 | LSR R20 ; /2
225 | ROR R21 ; /2
226 | LSR R20 ; /4
227 | ROR R21 ; /4
228 | LSR R20 ; /8
229 | ROR R21 ; /8
230 | LSR R20 ; /16
231 | ROR R21 ; /16

232
233 | LDS XL, PTR_VALOR_FINAL_TENSION

234 | LDS XH, PTR_VALOR_FINAL_TENSION + 1
235 | ST X+, R21
236 | ST X+, R20
237 | STS PTR_VALOR_FINAL_TENSION, XL
238 | STS PTR_VALOR_FINAL_TENSION + 1 , XH

239

240
241 | RET

242
243 | CALCULAR_VALOR_FINAL_CORRIENTE:
244 | LDI XL, LOW(SUMA_TOTAL_CORRIENTE)
245 | LDI XH, HIGH(SUMA_TOTAL_CORRIENTE)
246 | LD R5 , X+
247 | LD R4 , X+
248 | LD R3 , X+
249 | LD R2 , X+
250 | CALL RAIZ_CUADRADA; toma en R5(L) h a s t a R2 (M) ( o j o ! a l r e v e s que todo e l programa )
251 | ; d e v u el v e de sde R21 (L) a R20 (M)
252 | LSR R20 ; /2
253 | ROR R21 ; /2
254 | LSR R20 ; /4
255 | ROR R21 ; /4
256 | LSR R20 ; /8
257 | ROR R21 ; /8
258 | LSR R20 ; /16
259 | ROR R21 ; /16

260
261 | ; con promedio !
262 | LDS XL, PTR_VALOR_FINAL_CORRIENTE
263 | LDS XH, PTR_VALOR_FINAL_CORRIENTE + 1
264 | ST X+, R21
265 | ST X+, R20
266 | STS PTR_VALOR_FINAL_CORRIENTE, XL
267 | STS PTR_VALOR_FINAL_CORRIENTE + 1 , XH

268
269 | ; a c t u a l i z o y chequeo c on t ad o r
270 | LDS R16 , CTR_PTR_VALOR_FINAL
271 | DEC R16
272 | BREQ BRANCH_INICIALIZAR_PUNTERO_VALOR_FINAL
273 | STS CTR_PTR_VALOR_FINAL, R16
274 | SEGUIR_INICIALIZAR_PUNTERO_VALOR_FINAL:

275
276 | RET

277
278 | BRANCH_INICIALIZAR_PUNTERO_VALOR_FINAL:
279 | CALL INICIALIZAR_PUNTERO_VALOR_FINAL
280 | RJMP SEGUIR_INICIALIZAR_PUNTERO_VALOR_FINAL

281

282
283 | PROMEDIO_TENSION:
284 | LDI XL, LOW(VALOR_FINAL_TENSION)
285 | LDI XH, HIGH(VALOR_FINAL_TENSION)
286 | LDI R16 , 31
287 | LD R18 , X+
288 | LD R19 , X+
289 | FOR_PROMEDIO_TENSION:
290 | LD R20 , X+
291 | LD R21 , X+
292 | ADD R18 , R20
293 | ADC R19 , R21
294 | DEC R16
295 | BRNE FOR_PROMEDIO_TENSION
296 | LSR R19 ; /2
297 | ROR R18 ; /2
298 | LSR R19 ; /4
299 | ROR R18 ; /4
300 | LSR R19 ; /8
301 | ROR R18 ; /8
302 | LSR R19 ; /16
303 | ROR R18 ; /16
304 | LSR R19 ; /32
305 | ROR R18 ; /32
306 | RET

307
308 | PROMEDIO_CORRIENTE:
309 | LDI XL, LOW(VALOR_FINAL_CORRIENTE)

310 | LDI XH, HIGH(VALOR_FINAL_CORRIENTE)
311 | LDI R16 , CANT_PROM−1
312 | LD R18 , X+
313 | LD R19 , X+
314 | FOR_PROMEDIO_CORRIENTE:
315 | LD R20 , X+
316 | LD R21 , X+
317 | ADD R18 , R20
318 | ADC R19 , R21
319 | DEC R16
320 | BRNE FOR_PROMEDIO_CORRIENTE
321 | LSR R19 ; /2
322 | ROR R18 ; /2
323 | LSR R19 ; /4
324 | ROR R18 ; /4
325 | LSR R19 ; /8
326 | ROR R18 ; /8
327 | LSR R19 ; /16
328 | ROR R18 ; /16
329 | LSR R19 ; /32
330 | ROR R18 ; /32
331 | RET

### codigo/procesar.asm

1 ; f i l e : l c d . asm

2
3 . i n cl u d e "m328pdef . i n c "

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

6
7 | ; pi n e s
8 | .EQU D4 = 0 ; LSB de c omunic aci on de d a t o s ( s e usa en modo 4 b i t s )
9 | .EQU D5 = 1 ;
10 | .EQU D6 = 2 ;
11 | .EQU D7 = 3 ;MSB de c omunic aci on de d a t o s
12 | .EQU ENABLE = 4 ; pin de e n a bl e
13 | .EQU RS = 5 ; pin de RS

14

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

30
31 | ; mascaras
32 | .EQU MASK_4LSB = 0x0F
33 | .EQU MASK_MSB = 0 x80

34

35

36

37

38
39 | .MACRO DELAY ; macro para e s p e r a r
40 | CLR R18
41 | LDI R17 , @0
42 | FOR_1:
43 | DEC R17
44 | LDI R16 , @1
45 | FOR_2:
46 | DEC R16
47 | CPSE R16 , R18
48 | RJMP FOR_2
49 | CPSE R17 , R18
50 | RJMP FOR_1

51 .ENDM

52

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

67
68 | ENTER_WRITE_RAM:
69 | MOVE_TO NEXT_LINE
70 | LDI R21 , 15
71 | RJMP FOR_WRITE_RAM

72
73 | END_WRITE_RAM:
74 | ; te rmin a l a macro

75
76 .ENDM

77

78

79

80

81
82 | CONFIGURATION_LCD:
83 | ; c o n fi g u r o DDRB como s a l i d a
84 | LDI R16 , 0x3F
85 | OUT DDRB, R16
86 | LDI R16 , 0X80
87 | OUT DDRD, R16
88 | ; lim pi o ENABLE y RS
89 | CALL CLR_ENABLE
90 | CALL CLR_RS
91 | DELAY 2 5 5 , 255 ; e s p e r o ~15ms
92 | ; INICIO CONFIGURATION PARA MODO 4 BITS (SEGUN DATASHEET)
93 | LDI R20 , SET_8BITS_LONG
94 | CALL WRITE_8BITS
95 | DELAY 8 5 , 255 ; e s p e r o ~5ms
96 | LDI R20 , SET_8BITS_LONG
97 | CALL WRITE_8BITS
98 | DELAY 1 , 255 ; e s p e r o ~100 us
99 | LDI R20 , SET_8BITS_LONG
100 | CALL WRITE_8BITS
101 | DELAY 2 5 5 , 255
102 | LDI R20 , SET_4BITS_LONG
103 | CALL WRITE_8BITS
104 | DELAY 2 5 5 , 255
105 | ; FIN CONFIGURATION PARA MODO 4 BITS
106 | ; c o n fi g u r o l a f u n ci o n ( numero de l i n e a s , e t c )
107 | LDI R20 , FUNCTION_SET
108 | CALL WRITE_4BITS_INSTRUCTION
109 | DELAY 2 , 255
110 | ; c o n fi g u r o e l modo de en t r ad a ( inc remen to , decremento , de spl az amien t o , e t c )
111 | LDI R20 , ENTRY_MODE
112 | CALL WRITE_4BITS_INSTRUCTION
113 | DELAY 2 , 255
114 | ; c o n fi g u r o e l modo de di s p l a y ( parpadeo de c u r s o r , encendido , apagado , e t c )
115 | LDI R20 , SET_DISPLAY
116 | CALL WRITE_4BITS_INSTRUCTION
117 | DELAY 2 , 255
118 | ; lim pi o l a p a n t all a
119 | CALL CLEAN
120 | RET

121
122 | CLR_ENABLE: ; lim pi o l a s a l i d a de e n a bl e
123 | IN R16 , PORTB
124 | ANDI R16 , ~(1<<ENABLE)
125 | OUT PORTB, R16
126 | RET

128 | SET_ENABLE: ; s e t e o l a s a l i d a de e n a bl e
129 | IN R16 , PORTB
130 | ORI R16 , (1<<ENABLE)
131 | OUT PORTB, R16
132 | RET

133
134 | CLR_RS: ; lim pi o l a s a l i d a de RS
135 | IN R16 , PORTB
136 | ANDI R16 , ~(1<<RS)
137 | OUT PORTB, R16
138 | RET

139
140 | SET_RS: ; s e t e o l a s a l i d a de RS
141 | IN R16 , PORTB
142 | ORI R16 , (1<<RS)
143 | OUT PORTB, R16
144 | RET

145

146

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

158
159 | WRITE_4BITS_INSTRUCTION:
160 | ; r e c i b e en R20 l o que s e q ui e r e e s c r i b i r
161 | CALL SET_ENABLE ; a c ti v o ENABLE
162 | CALL CLR_RS ; RS = 0 ( e s t o y mandando una i n s t r u c c i o n )
163 | IN R16 , PORTB ; c a r g o PORTB
164 | MOV R17 , R20 ; c o pi o R20 a R17 para no p e r d e rl o
165 | SWAP R17 ; i n t e r c am bi o l o s n i b b l e s ya que p rime r o s e manda e l ni b bl e a l t o
166 | ANDI R16 , ~MASK_4LSB ; lim pi o l o s ul tim o s de R16 (PORTB)
167 | ANDI R17 , MASK_4LSB ; d e j o s o l o l o s ul tim o s de R17 para no p i s a r a PORTB
168 | OR R16 , R17 ; c o pi o R17 a R16
169 | OUT PORTB, R16 ; s a c o a PORTB
170 | DELAY 1 , 255 ; e s p e r o al g u n o s mic r o se gund o s
171 | CALL CLR_ENABLE ; ENABLE = 0 , mando e l dato
172 | DELAY 1 , 255 ; e s p e r o al g u n o s mic r o se gund o s
173 | ; l o mismo pe r o enviando e l ni b bl e mas b a j o
174 | CALL SET_ENABLE
175 | MOV R17 , R20
176 | ANDI R16 , ~MASK_4LSB
177 | ANDI R17 , MASK_4LSB
178 | OR R16 , R17
179 | OUT PORTB, R16
180 | DELAY 1 , 255
181 | CALL CLR_ENABLE
182 | DELAY 1 , 255
183 | RET

184
185 | WRITE_4BITS_CHARACTER:
186 | ; r e c i b e en R20 l o que s e q ui e r e e s c r i b i r
187 | CALL SET_ENABLE; d e s a c ti v o e n a bl e
188 | CALL SET_RS ; a c ti v o RS ( e s c r i b o d a t o s )
189 | IN R16 , PORTB
190 | MOV R17 , R20 ; c o pi o R20 a R17
191 | SWAP R17
192 | ANDI R16 , ~MASK_4LSB ; lim pi o l o s ul tim o s de R16
193 | ANDI R17 , MASK_4LSB ; d e j o s o l o l o s ul tim o s de R17
194 | OR R16 , R17 ; c o pi o R17 a R16
195 | OUT PORTB, R16 ; s a c o a PORTB
196 | DELAY 1 , 255
197 | CALL CLR_ENABLE ; a c ti v o e n a bl e
198 | DELAY 1 , 255
199 | CALL SET_ENABLE ; d e s a c ti v o e n a bl e
200 | MOV R17 , R20 ; c o pi o de nuevo
201 | ANDI R16 , ~MASK_4LSB ; lim pi o l o s ul tim o s de R16
202 | ANDI R17 , MASK_4LSB ; d e j o s o l o l o s ul tim o s de R17

203 | OR R16 , R17 ; c o pi o R17 a R16
204 | OUT PORTB, R16 ; s a c o a PORTB
205 | DELAY 1 , 255
206 | CALL CLR_ENABLE ; a c ti v o e n a bl e
207 | DELAY 1 , 255
208 | RET

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

216
217 | ; f u n ci o n que imprime e l t e x t o b a se en e l l c d
218 | TEXTO_LCD:
219 | LDI R23 , LOW(TEX_TENSION<<1)
220 | LDI R24 , HIGH(TEX_TENSION<<1)
221 | LDI R25 , INICIO_LCD
222 | WRITE_FROM_ROM
223 | LDI R23 , LOW(TEX_CORRIENTE<<1)
224 | LDI R24 , HIGH(TEX_CORRIENTE<<1)
225 | LDI R25 , FIN_NUM_V_LCD
226 | WRITE_FROM_ROM
227 | LDI R23 , LOW(TEX_COSFI<<1)
228 | LDI R24 , HIGH(TEX_COSFI<<1)
229 | LDI R25 , NEXT_LINE
230 | WRITE_FROM_ROM
231 | RET

### codigo/lcd.asm

1 ; f i l e : imp rimi r . asm

2
3 | IMPRIMIR_TODO:
4 | PUSH R16
5 | PUSH R17
6 | PUSH R18
7 | PUSH R19
8 | PUSH R20
9 | PUSH R21
10 | PUSH R23
11 | PUSH R24
12 | PUSH R25
13 | CLR R16
14 | STS CTR_LCD, R16
15 | STS CTR_LCD + 1 , R16
16 | CALL CONVERTIR_A_VALOR_E_IMPRIMIR_TENSION
17 | CALL CONVERTIR_A_VALOR_E_IMPRIMIR_CORRIENTE
18 | CALL CONVERTIR_IMPRIMIR_COFF
19 | POP R25
20 | POP R24
21 | POP R23
22 | POP R21
23 | POP R20
24 | POP R19
25 | POP R18
26 | POP R17
27 | POP R16
28 | RET

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

35
36 | CALL PROMEDIO_TENSION; CALCULA EL PROMEDIO DE LA TENSION Y DEVUELVE EN R23 (L) Y R24 (M)

37
38 | LSL R18
39 | ROL R19
40 | LSL R18
41 | ROL R19

42
43 | ADD R23 , R18
44 | ADC R24 , R19

45 | LDI R25 , FIN_V_LCD
46 | WRITE_FROM_ROM
47 | RET

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

54
55 | CALL PROMEDIO_CORRIENTE

56
57 | LDI R16 , 6
58 | MUL R18 , R16
59 | ADD R23 , R0
60 | ADC R24 , R1
61 | MUL R19 , R16
62 | ADD R24 , R0
63 | LDI R25 , FIN_I_LCD
64 | WRITE_FROM_ROM
65 | RET

66
67 | ; l e e e l v al o r de d e s f a s a j e de l a ram y l u e g o busca en l a t a bl a e imprime mediante l a macro
68 | ;WRITE_FROM_ROM
69 | CONVERTIR_IMPRIMIR_COFF:
70 | PUSH R0
71 | PUSH R1
72 | LDI XL, LOW(DESFASAJE)
73 | LDI XH, HIGH(DESFASAJE)
74 | LDI R23 , LOW(TABLA_COSFI<<1)
75 | LDI R24 , HIGH(TABLA_COSFI<<1)
76 | LD R18 , X
77 | LDI R16 , 6
78 | MUL R18 , R16
79 | ADD R23 , R0
80 | ADC R24 , R1
81 | LDI R25 , FIN_COSFI_LCD
82 | WRITE_FROM_ROM

83
84 | POP R1
85 | POP R0
86 | RET

### codigo/imprimir.asm

1 ; f i l e : d e s f a s a j e . asm

2
3 . i n cl u d e "m328pdef . i n c "

4

5
6 | .EQU MASK_LECTURA_TENSION = 0 x04
7 | .EQU PENDIENTE = 10
8 | .EQU ORDENADA_ORIGEN = 25
9 | .EQU CONFIG_ACSR = 0 x08

10
11 | .DEF TEMP2 = R17
12 | .DEF TEMP1 = R16
13 | .DEF TIEMPO_ARRIBA_L = R19

14

15
16 CONFIGURAR_DESFASAJE:

17
18 | LDI TEMP2, CONFIG_ACSR
19 | OUT ACSR, TEMP2

20
21 | ;SETEO EL PUERTO D DE ENTRADA
22 | LDI TEMP2,DDRD
23 | ANDI TEMP2,MASK_LECTURA_TENSION
24 | OUT DDRD,TEMP2
25 | ; [ FIN ]SETEO EL PUERTO D DE ENTRADA

26
27 | ; HABILITO LA INTERRUPCION POR PIN 5 DEL PUERTO D
28 | LDS TEMP2,PCMSK2
29 | ORI TEMP2,(1<<PCINT21 )
30 | STS PCMSK2,TEMP2
31 | ; [ FIN ] HABILITO LA INTERRUPCION POR PIN 5 DEL PUERTO D

33 | ; HABILITO LA INTERRUPCION POR PUERTO D
34 | LDS TEMP2, PCICR
35 | ORI TEMP2, (1<<PCIE2 )
36 | STS PCICR,TEMP2
37 | ; [ FIN ] HABILITO LA INTERRUPCION POR PUERTO D

38
39 | LDS TEMP2,TCCR1A;SETEO PARA QUE EL TIMER CUENTE LO MAS QUE PUEDA
40 | ANDI TEMP2, 0 x00 ;SETEO PARA QUE EL TIMER CUENTE LO MAS QUE PUEDA
41 | STS TCCR1A,TEMP2;SETEO PARA QUE EL TIMER CUENTE LO MAS QUE PUEDA

42

43
44 | ; INICIALIZACION DE VARIABLES
45 | CLR TIEMPO_ARRIBA_L

46

47
48 | ;CONFIGURO EL INTERRUPT DEL TIMER
49 | LDS TEMP2, TIMSK1
50 | ORI TEMP2, 0
51 | STS TIMSK1, TEMP2

52
53 | RET
54 | ; [ FIN ] INICIALIZACION DE VARIABLES

55
56 SET_TIMER1:

57
58 | LDI TEMP2, 0 x02 ;PRESCALEO Y PRENDO EL TIMER
59 | STS TCCR1B,TEMP2;PRESCALEO Y PRENDO EL TIMER
60 | RET

61
62 | UNSET_TIMER1:
63 | LDI TEMP2, 0 x00 ;APAGO EL TIMER
64 | STS TCCR1B,TEMP2;APAGO EL TIMER
65 | RET

66
67 | PRENDER_TIMER:
68 | CLR TEMP2
69 | STS TCNT1H, TEMP2
70 | STS TCNT1L, TEMP2
71 | NOP
72 | NOP
73 | NOP
74 | NOP
75 | NOP
76 | NOP
77 | CALL SET_TIMER1
78 | RET

79

80

81
82 | APAGAR_Y_GUARDAR_TIMER:
83 | CALL UNSET_TIMER1 ; apago e l tim e r
84 | CALL GUARDAR_TIMER ; guardo e l v al o r d el tim e r
85 | RET

86
87 | GUARDAR_TIMER:
88 | LDS TEMP2,TCNT1L
89 | LDS TEMP1,TCNT1H
90 | ; SHIFTEO | 6 A LA DERECHA, PARA ARMAR UN BIT MEZCLA DEL BIT LOW Y HIGH.
91 | LSR TEMP2
92 | LSR TEMP2
93 | LSR TEMP2
94 | LSR TEMP2
95 | LSR TEMP2
96 | LSR TEMP2
97 | ; SHIFTEO 2 A LA IZQUIERDA
98 | LSL TEMP1
99 | LSL TEMP1
100 | OR TEMP2, TEMP1
101 | CPI TEMP2, 15
102 | BRLO SEGUIR_FILTRO
103 | STS DESFASAJE, TEMP2
104 | SEGUIR_FILTRO:

105
106 RET

108 | HANDLER_XOR:
109 | PUSH TEMP1
110 | PUSH TEMP2
111 | PUSH TIEMPO_ARRIBA_L
112 | IN TEMP2, SREG
113 | PUSH TEMP2

114
115 | IN TEMP1, ACSR
116 | IN TEMP2, PIND
117 | EOR TEMP1, TEMP2
118 | SBRC TEMP1, 5
119 | CALL PRENDER_TIMER
120 | CALL APAGAR_Y_GUARDAR_TIMER

121
122 | POP TEMP2
123 | OUT SREG, TEMP2
124 | POP TIEMPO_ARRIBA_L
125 | POP TEMP2
126 | POP TEMP1

127
128 | RETI

### codigo/desfasaje.asm

1 ; f i l e : cuadrado . asm

2
3 . i n cl u d e "m328pdef . i n c "

4
5 .DEF aux_1 = R19

6

7
8 | ; M ul t i p li c a R21−R22 ∗ R21−R22 y l o pone en R23−R24−R25
9 | CUADRADO:
10 | PUSH aux_1
11 | PUSH R0
12 | PUSH R1
13 | CLR aux_1
14 | CLR R25
15 | MUL R21 , R21
16 | MOV R23 , R0
17 | MOV R24 , R1

18
19 | MUL R22 , R21
20 | ADD R24 , R0
21 | ADC R25 , aux_1
22 | ADD R24 , R0
23 | ADC R25 , aux_1
24 | ADD R25 , R1
25 | ADD R25 , R1

26
27 | MUL R22 , R22
28 | ADD R25 , R0

29

30
31 | POP R1
32 | POP R0
33 | POP aux_1
34 | RET

### codigo/cuadrado.asm

1 ; f i l e : adc . asm

2
3 | ; comandos ADC
4 | .EQU ADMUX_CONFIG = 0 x40
5 | .EQU ADCSRA_CONFIG = 0 x88
6 | .EQU DIDR0_CONFIG = 0x3F

7

8

9
10 CONFIGURAR_ADC:

11
12 | ; c o n fi g u r o l o s pi n e s de DDRC como en t r ad a
13 | IN R16 , DDRC
14 | LDI R16 , 0 x00
15 | OUT DDRC, R16

17 | ; c o n fi g u r o e l time r 0 Y ADC

18
19 | IN R16 , TCCR0A
20 | ANDI R16 , 0 x00
21 | OUT TCCR0A, R16

22

23
24 | LDI R16 , 0 x02
25 | OUT TCCR0B, R16

26

27
28 | LDI R16 , 0 x01
29 | STS TIMSK0, R16

30
31 | LDI R16 , ADMUX_CONFIG
32 | STS ADMUX, R16
33 | LDI R16 , ADCSRA_CONFIG
34 | STS ADCSRA, R16
35 | LDI R16 , DIDR0_CONFIG
36 | STS DIDR0, R16

37
38 | RET

39

40
41 | CLEAN_ADIF:
42 | LDS R16 , ADCSRA
43 | ORI R16 , (1<<ADIF)
44 | STS ADCSRA, R16
45 | RET

46
47 | START_ADC:
48 | LDS R16 , ADCSRA
49 | ORI R16 , (1<<ADSC)
50 | STS ADCSRA, R16
51 | RET

52
53 | HANDLER_TIMER0:
54 | PUSH R16
55 | IN R16 , SREG
56 | PUSH R16
57 | PUSH R17
58 | PUSH R18
59 | PUSH R19
60 | LDI R16 , 181
61 | OUT TCNT0, R16
62 | CALL START_ADC
63 | LDS R16 , CTR_LCD + 1
64 | SBRS R16 , 7
65 | CALL AUMENTAR_CONTADOR_LCD

66
67 | POP R19
68 | POP R18
69 | POP R17
70 | POP R16
71 | OUT SREG, R16
72 | POP R16
73 | RETI

74
75 | AUMENTAR_CONTADOR_LCD:
76 | CLR R16
77 | LDI R17 , 1
78 | LDS R18 , CTR_LCD
79 | LDS R19 , CTR_LCD + 1
80 | ADD R18 , R17
81 | ADC R19 , R16
82 | STS CTR_LCD, R18
83 | STS CTR_LCD + 1 , R19
84 | RET

85

86
87 | HANDLER_ADC:
88 | PUSH R16 ; pusheo l o que uso
89 | IN R16 , SREG
90 | PUSH R16
91 | PUSH R17

92 | PUSH R26
93 | PUSH R27
94 | LDS XL, PTR_PENDIENTES_ESCRITURA ; c a r g o e l pun te r o que h abi a guardado a n t e s
95 | LDS XH, PTR_PENDIENTES_ESCRITURA + 1
96 | LDS R16 , ADCL ; guardo l a p a r t e b a j a d el ADC
97 | ST X+, R16 ; l o guardo en ram y sumo
98 | LDS R17 , ADCH ; guardo l a p a r t e a l t a d el ADC
99 | ST X+, R17 ; l o guardo en ram
100 | STS PTR_PENDIENTES_ESCRITURA, XL ; vuel v o a gu a rd a r e l pun te r o
101 | STS PTR_PENDIENTES_ESCRITURA + 1 , XH
102 | LDS R17 , CTR_PENDIENTES ; sumo a l c on t ad o r de p e n di e n t e s para que s e e n t e r e e l programa
103 | INC R17
104 | STS CTR_PENDIENTES, R17
105 | LDS R17 , CTR_PTR_PENDIENTES_ESCRITURA ; sumo a l c on t ad o r para s a b e r cuando r e i n i c i a r e l
| pun te r o
106 | DEC R17
107 | STS CTR_PTR_PENDIENTES_ESCRITURA, R17 ; guardo e l c on t ad o r
108 | BREQ BRANCH_INICIALIZAR_PUNTERO_ADC ; s i e s c e r o r e i n i c i o e l pun te r o
109 | SEGUIR_INICIALIZAR_PUNTERO_ADC:
110 | LDS R16 , ADMUX ; c a r g o e l m ul ti pl e x o r d el adc
111 | LDI R17 , 1
112 | EOR R16 , R17 ; hago e l xor para i n t e r c am bi a r e n t r e t e n si o n y c o r r i e n t e
113 | STS ADMUX, R16
114 | POP R27 ; popeo todo de nuevo
115 | POP R26
116 | POP R17
117 | POP R16
118 | OUT SREG, R16
119 | POP R16

120
121 | RETI

122

123
124 | BRANCH_INICIALIZAR_PUNTERO_ADC:
125 | CALL INICIALIZAR_PUNTERO_ADC
126 | RJMP SEGUIR_INICIALIZAR_PUNTERO_ADC

127

128
129 | INICIALIZAR_PUNTERO_ADC:
130 | LDI XL, LOW(PENDIENTES) ; c a r g o e l pun te r o de p e n di e n t e s
131 | LDI XH, HIGH(PENDIENTES)
132 | STS PTR_PENDIENTES_ESCRITURA, XL ; guardo e l pun te r o en mi e s p a ci o para e l pun te r o
133 | STS PTR_PENDIENTES_ESCRITURA + 1 , XH
134 | LDI R16 , 16 ; r e i n i c i o e l c on t ad o r
135 | STS CTR_PTR_PENDIENTES_ESCRITURA, R16 ; guardo e l c on t ad o r
136 | RET

### codigo/adc.asm

# 11. Apéndice III: Presupuesto del proyecto

### Display LCD 16x2: $230

### Sensor de efecto Hall ACS712 ± 5A: $220

### Comparador LM393: $15

### Arduino UNO: $500

### Amplificador Operacional LM358: $25

### Transformador 220V-18V: $1000

### Tomacorriente 220V: $30

### Enchufe 220V: $70

### 2 Presets 100 KΩ: $90

### Total: $2180
