fiuba-labo-de-micro-miercoles/2019-2c-proyecto-Cofimetro/(threads)

Thread 3 (2019-09-30):

Anteproyecto Beta

axelitz, 2019-09-30:
Se subió una primera versión del anteproyecto del Cofímetro

rarias, 2019-09-30:
Ver correcciones en
https://github.com/fiuba-labo-de-micro-miercoles/2019-2c-proyecto-Cofimetro/tree/master/doc/anteproyecto
Pasen a la versión 2 cuando hagan los cambios indicados.

Closed 2019-11-04.

Thread 5 (2019-10-23):

Anteproyecto V2

axelitz, 2019-10-23:
Se subió una segunda versión del anteproyecto del Cofímetro

rarias, 2019-10-28:
La carátula no es la oficial de la materia.
El bloque arduino debe ser reemplazado por uno que diga MICROCONTROLADOR.
El ACS712 se supone que tiene 2 bornes de entrada x los que pasa la corriente a medir.
Dibujar la línea, la carga y cómo se conectan el trafo y el ACS712.
La salida del MICRO al display debe indicar el número de conexiones (típicamente 4 de datos y 3 de control).
No queda claro qué con qué compara el comparador ( y etiquetar sólo como comparador de tensión sin aclarar el número de parte específico). Se supone que a la salida del trafo hay un divisor resistivo (que hay que mostrarlo).
Además falta la alimentación del micro.

Thread 6 (2019-11-04):

circuito esquemático

rarias, 2019-11-04:
Es necesario que suban un circuito esquemático, aunque sea parcial de lo que ya tienen conectado.
Se recomienda el uso de Kicad para dibujar el circuito.
