fiuba-labo-de-micro-miercoles/2019-2c-proyecto-Cofimetro/esquematico/esquematico.pdf

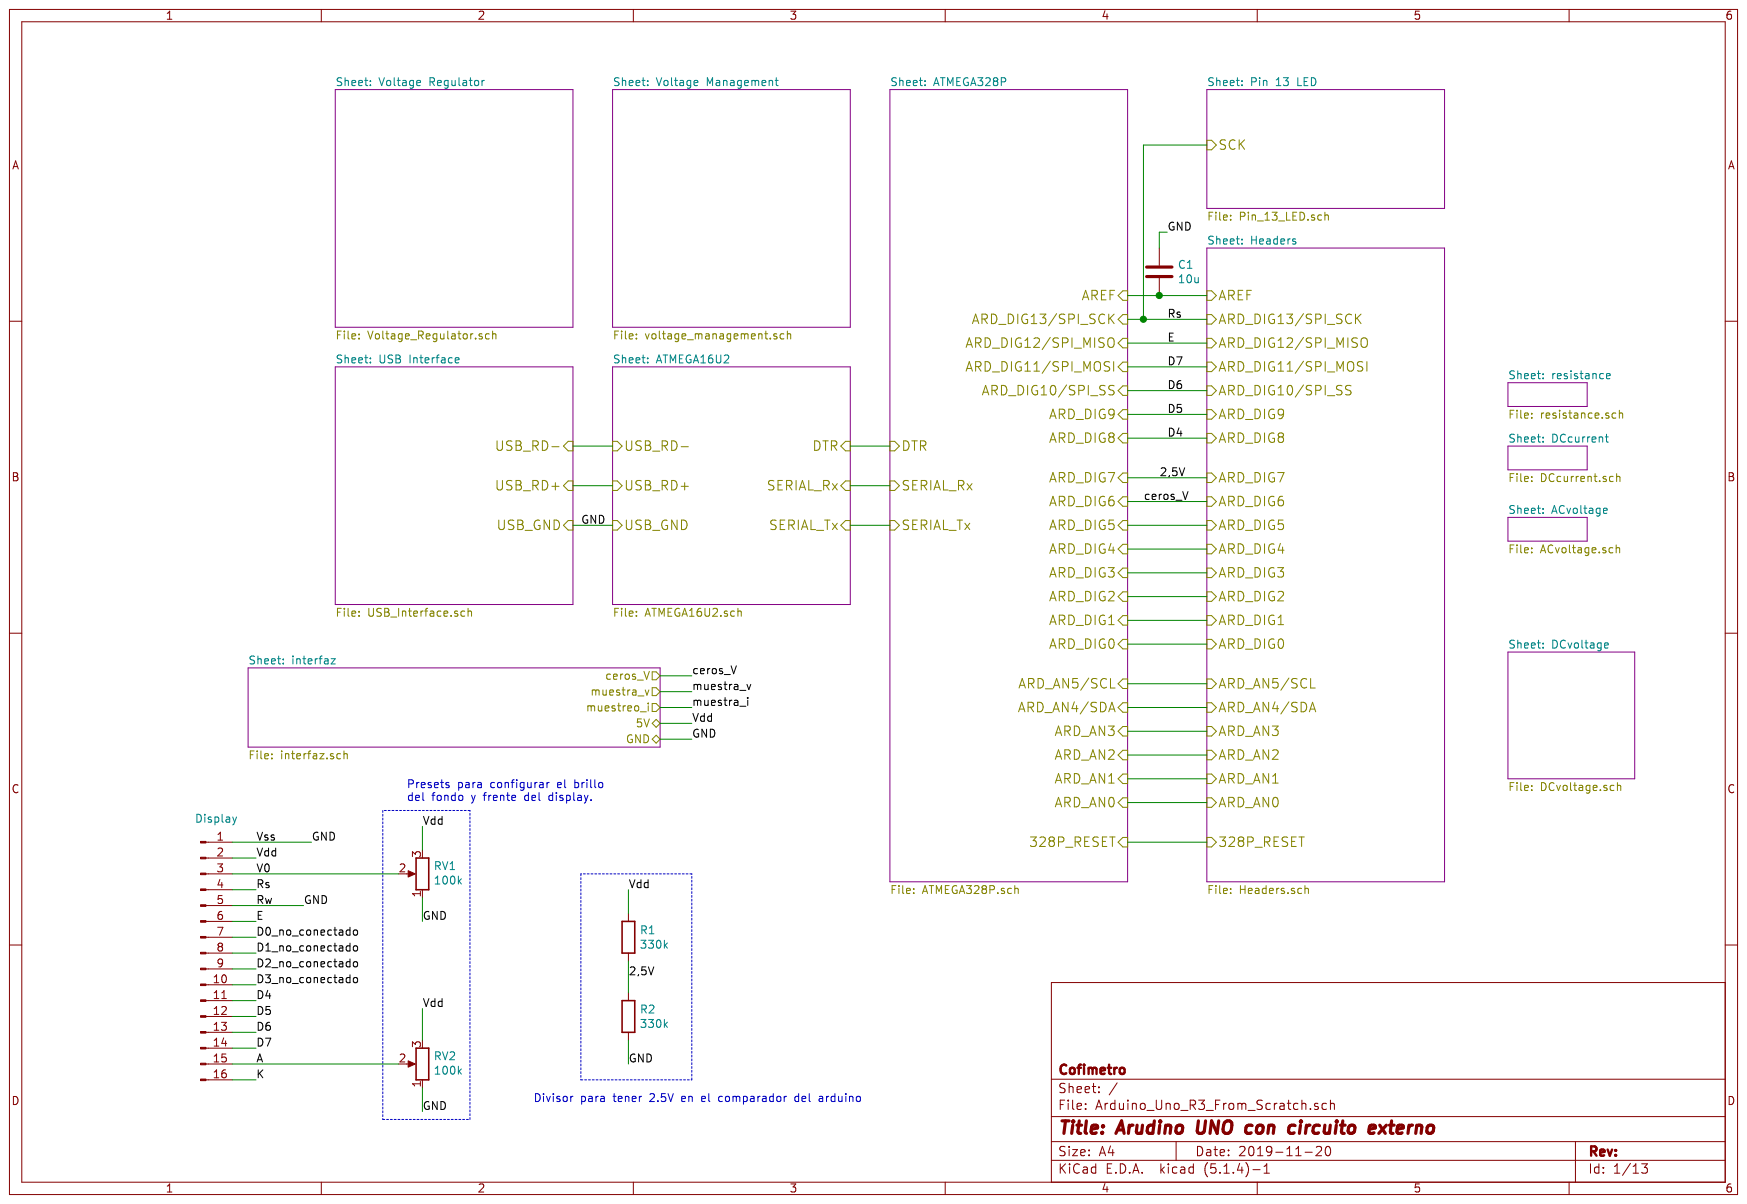
[picture p25: page 1]

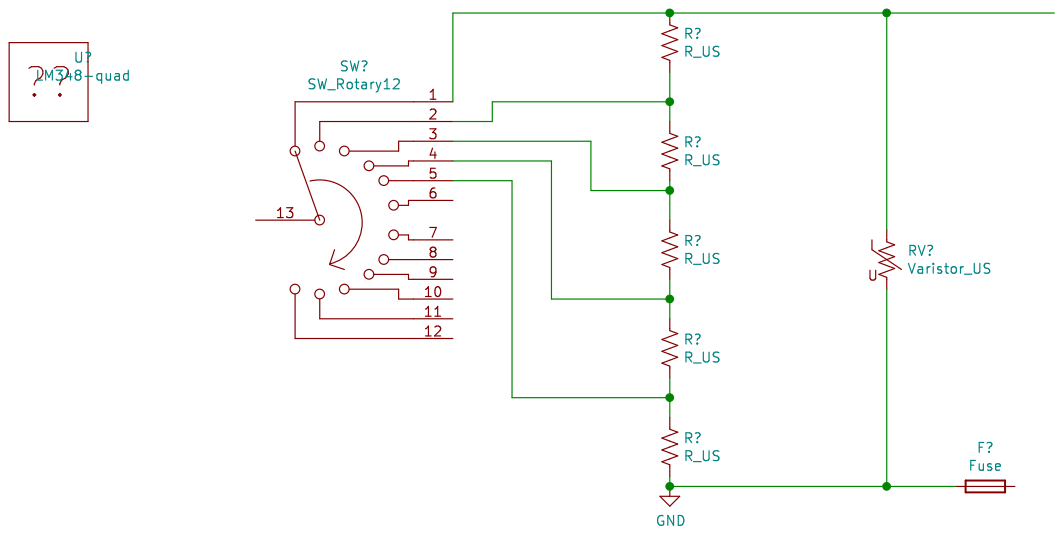
[picture p26: page 2]

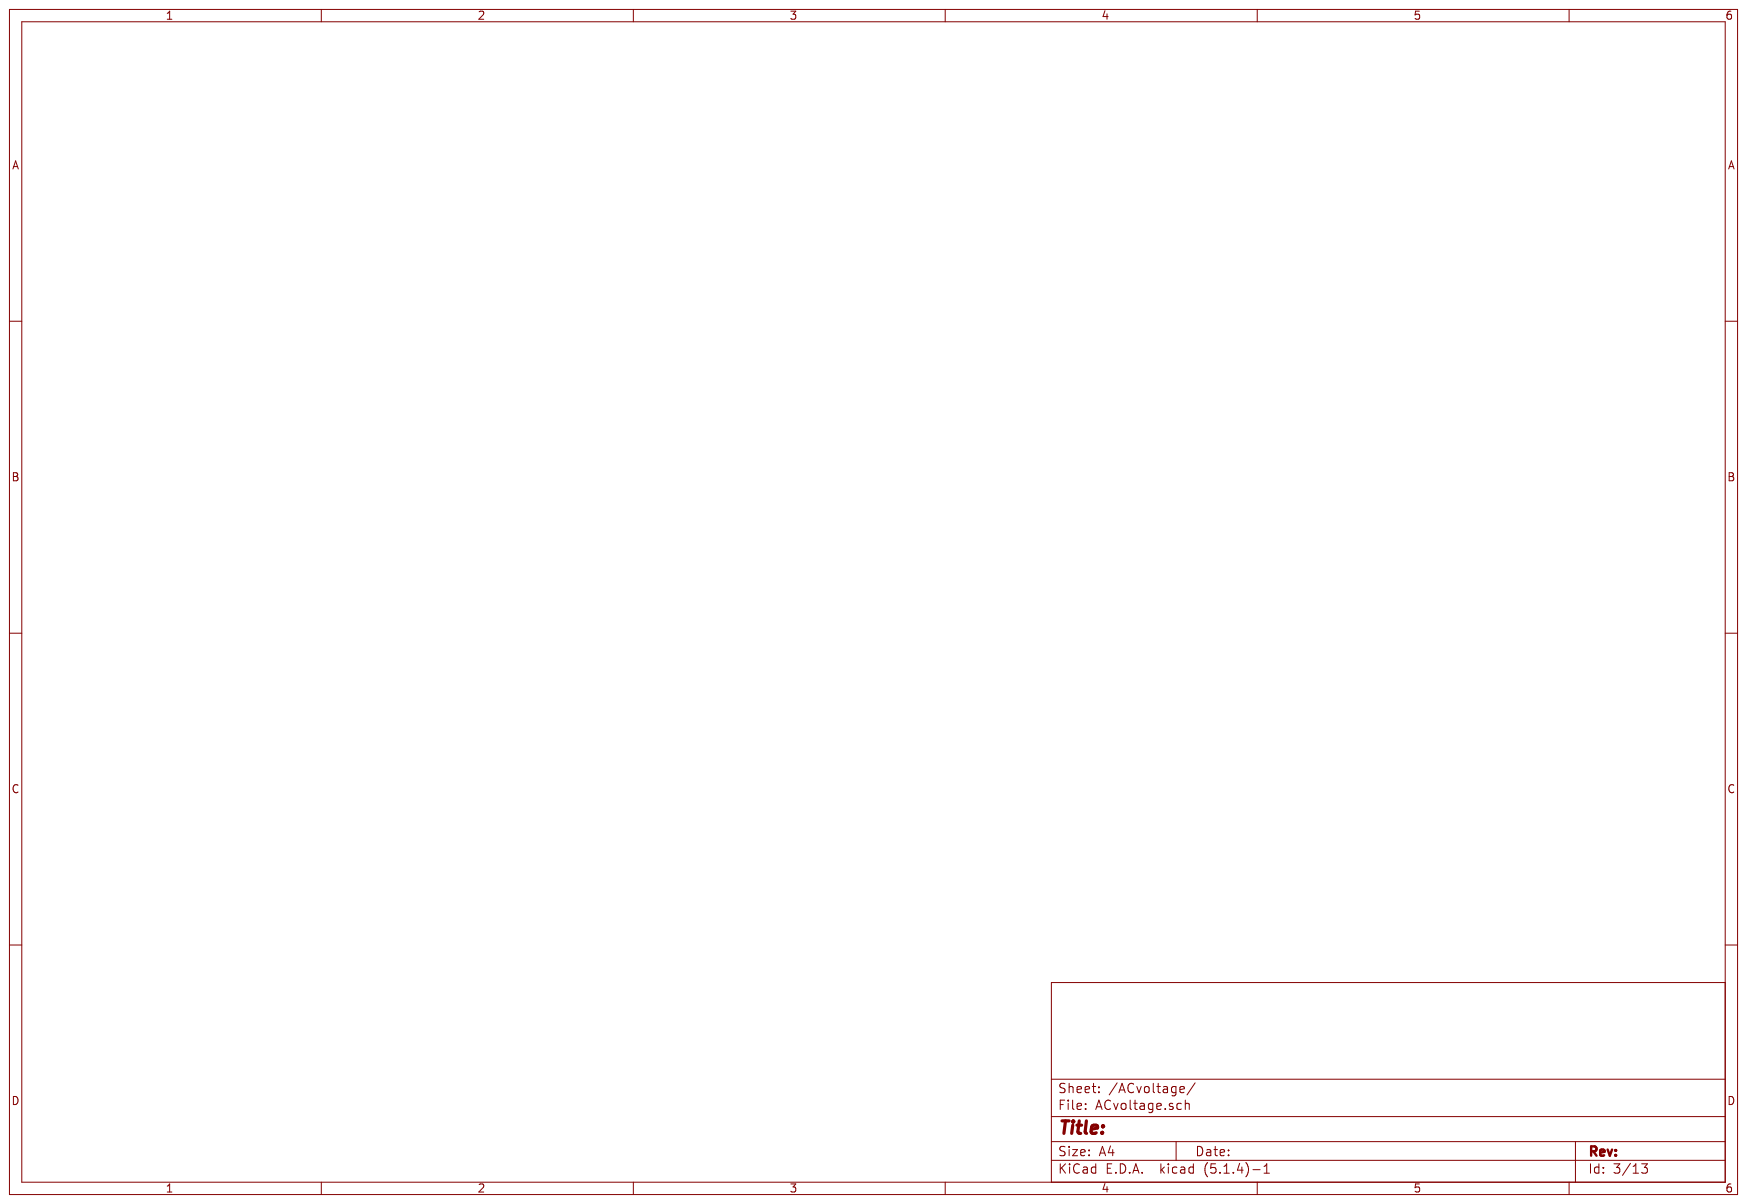
[picture p27: page 3]

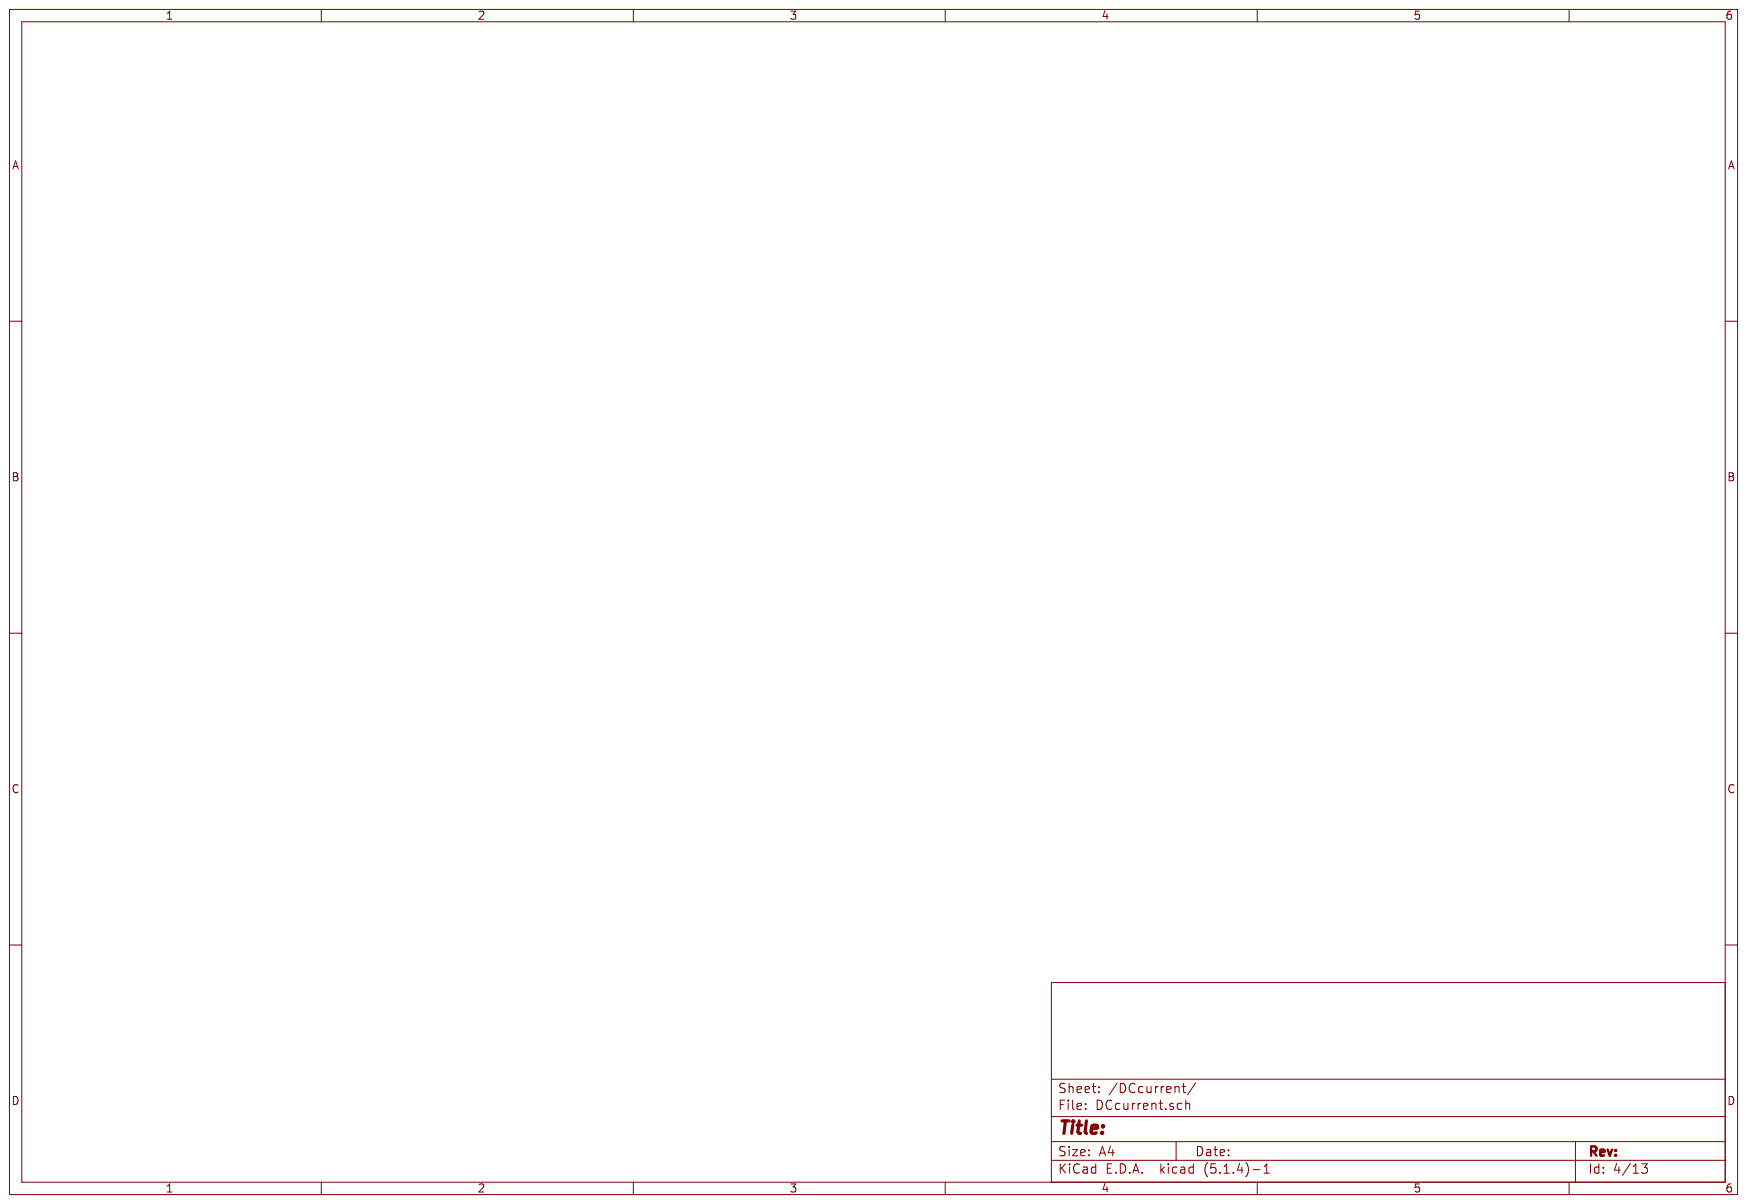
[picture p28: page 4]

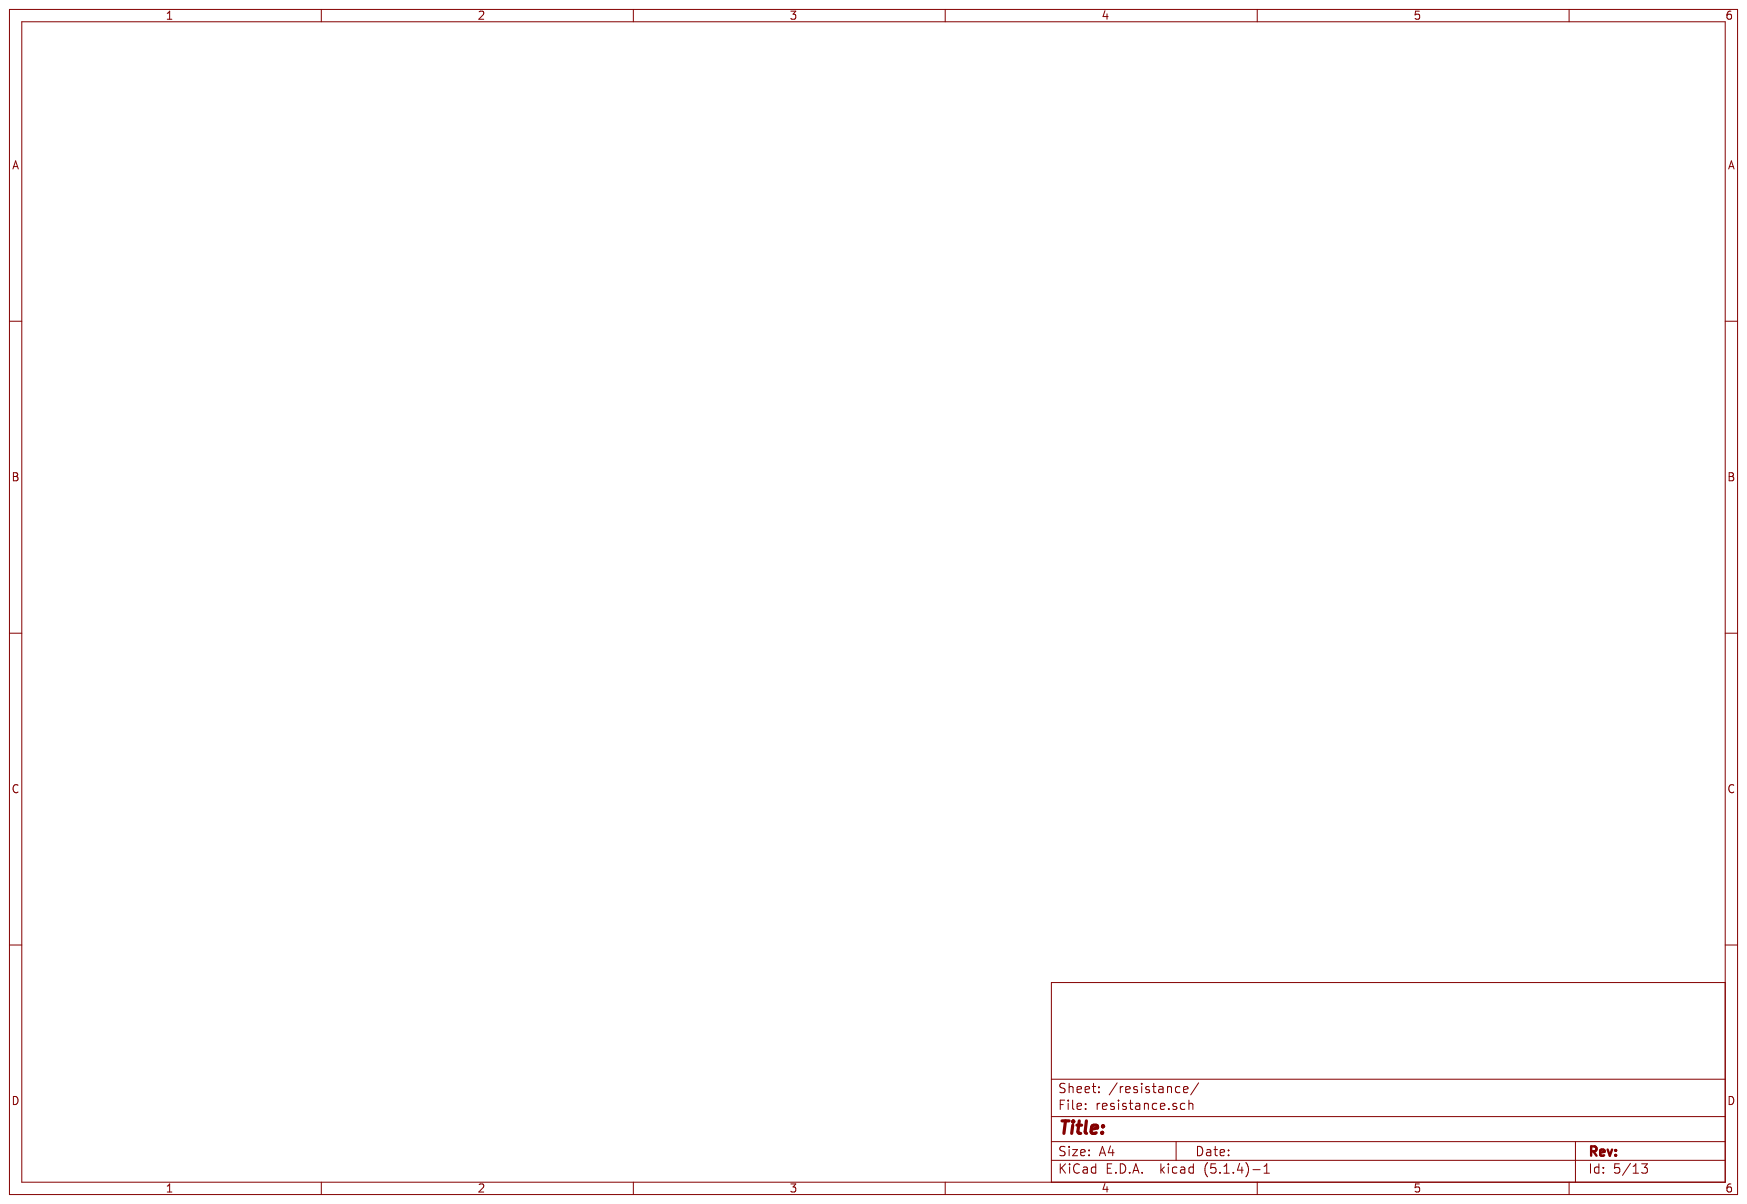
[picture p29: page 5]

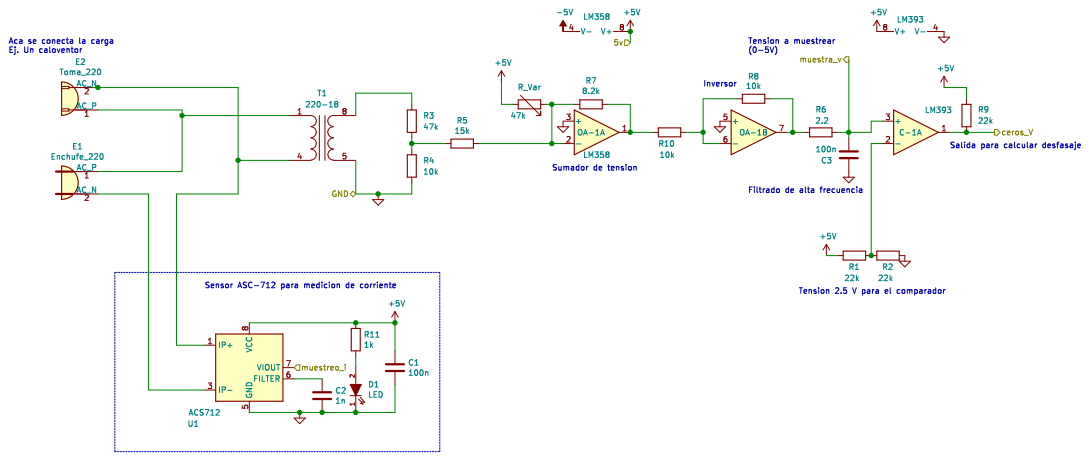
[picture p30: page 6]

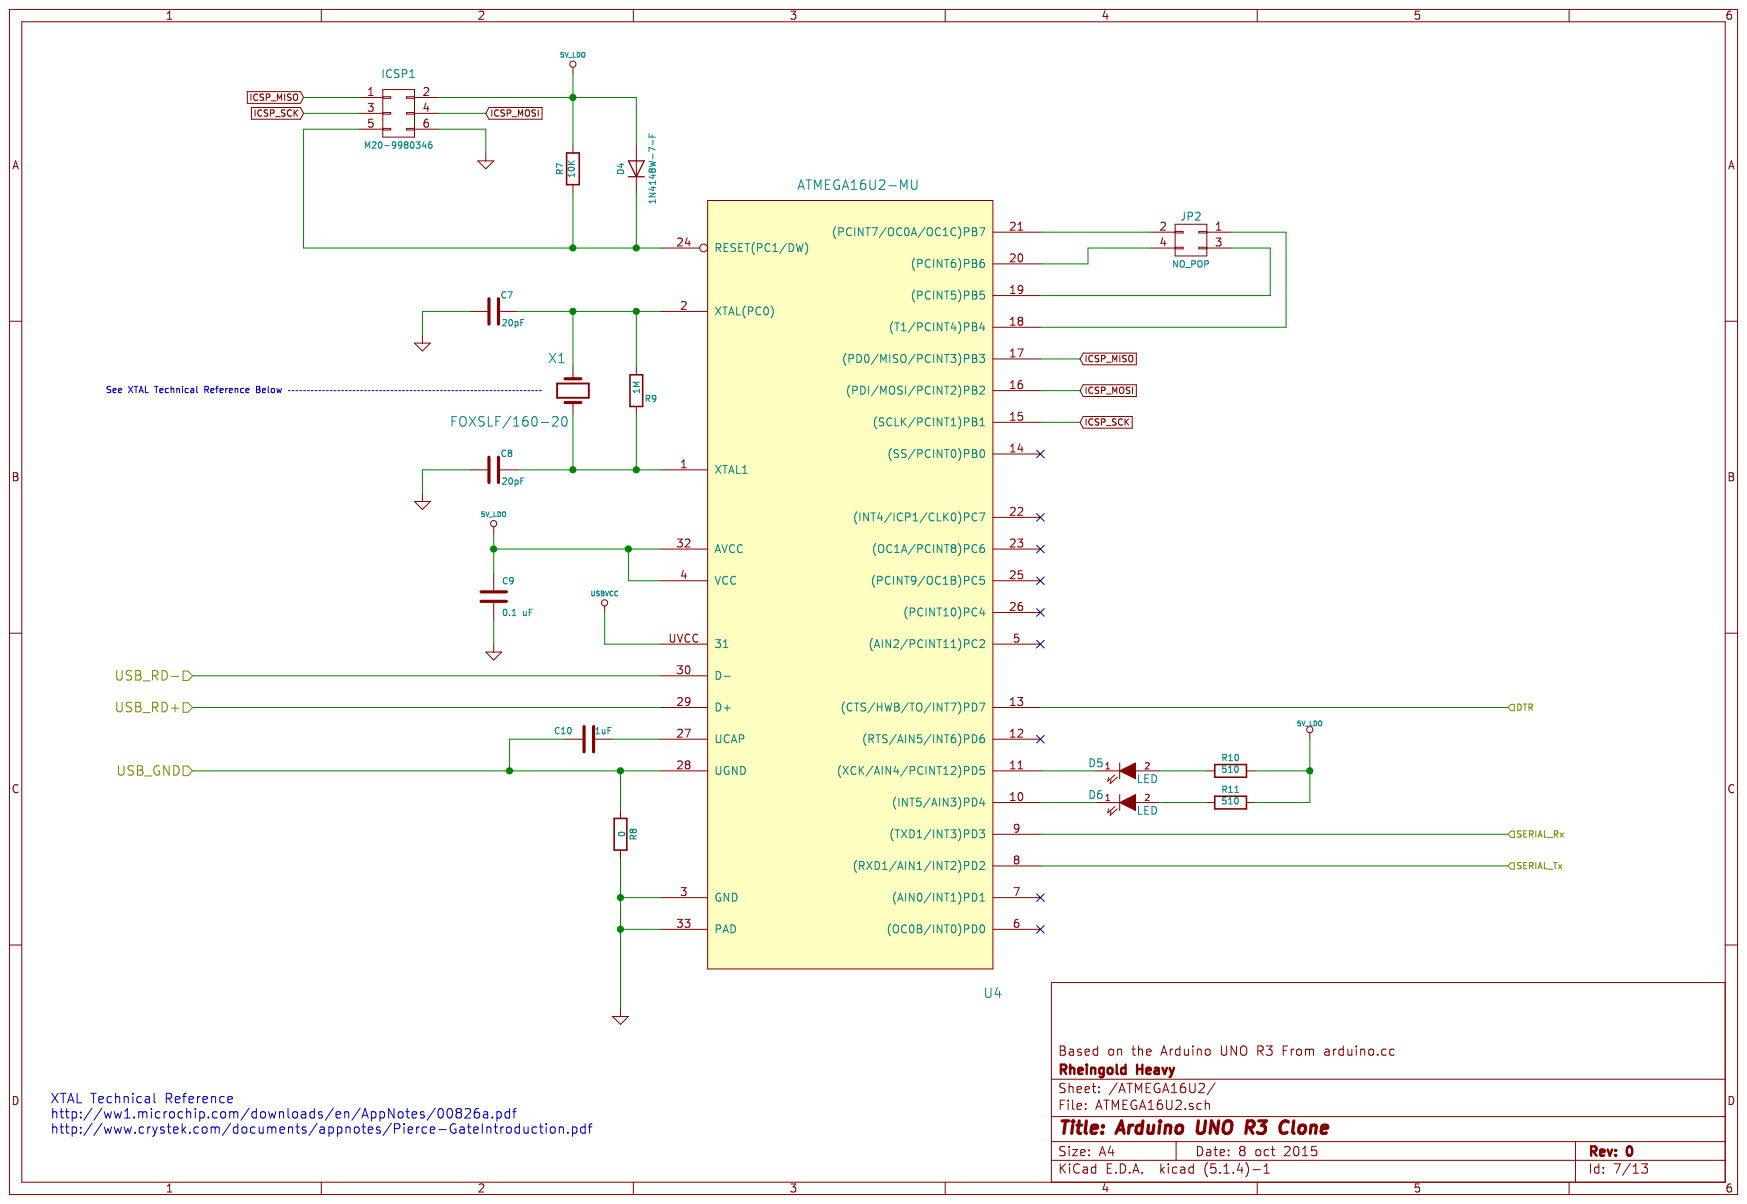
[picture p31: page 7]

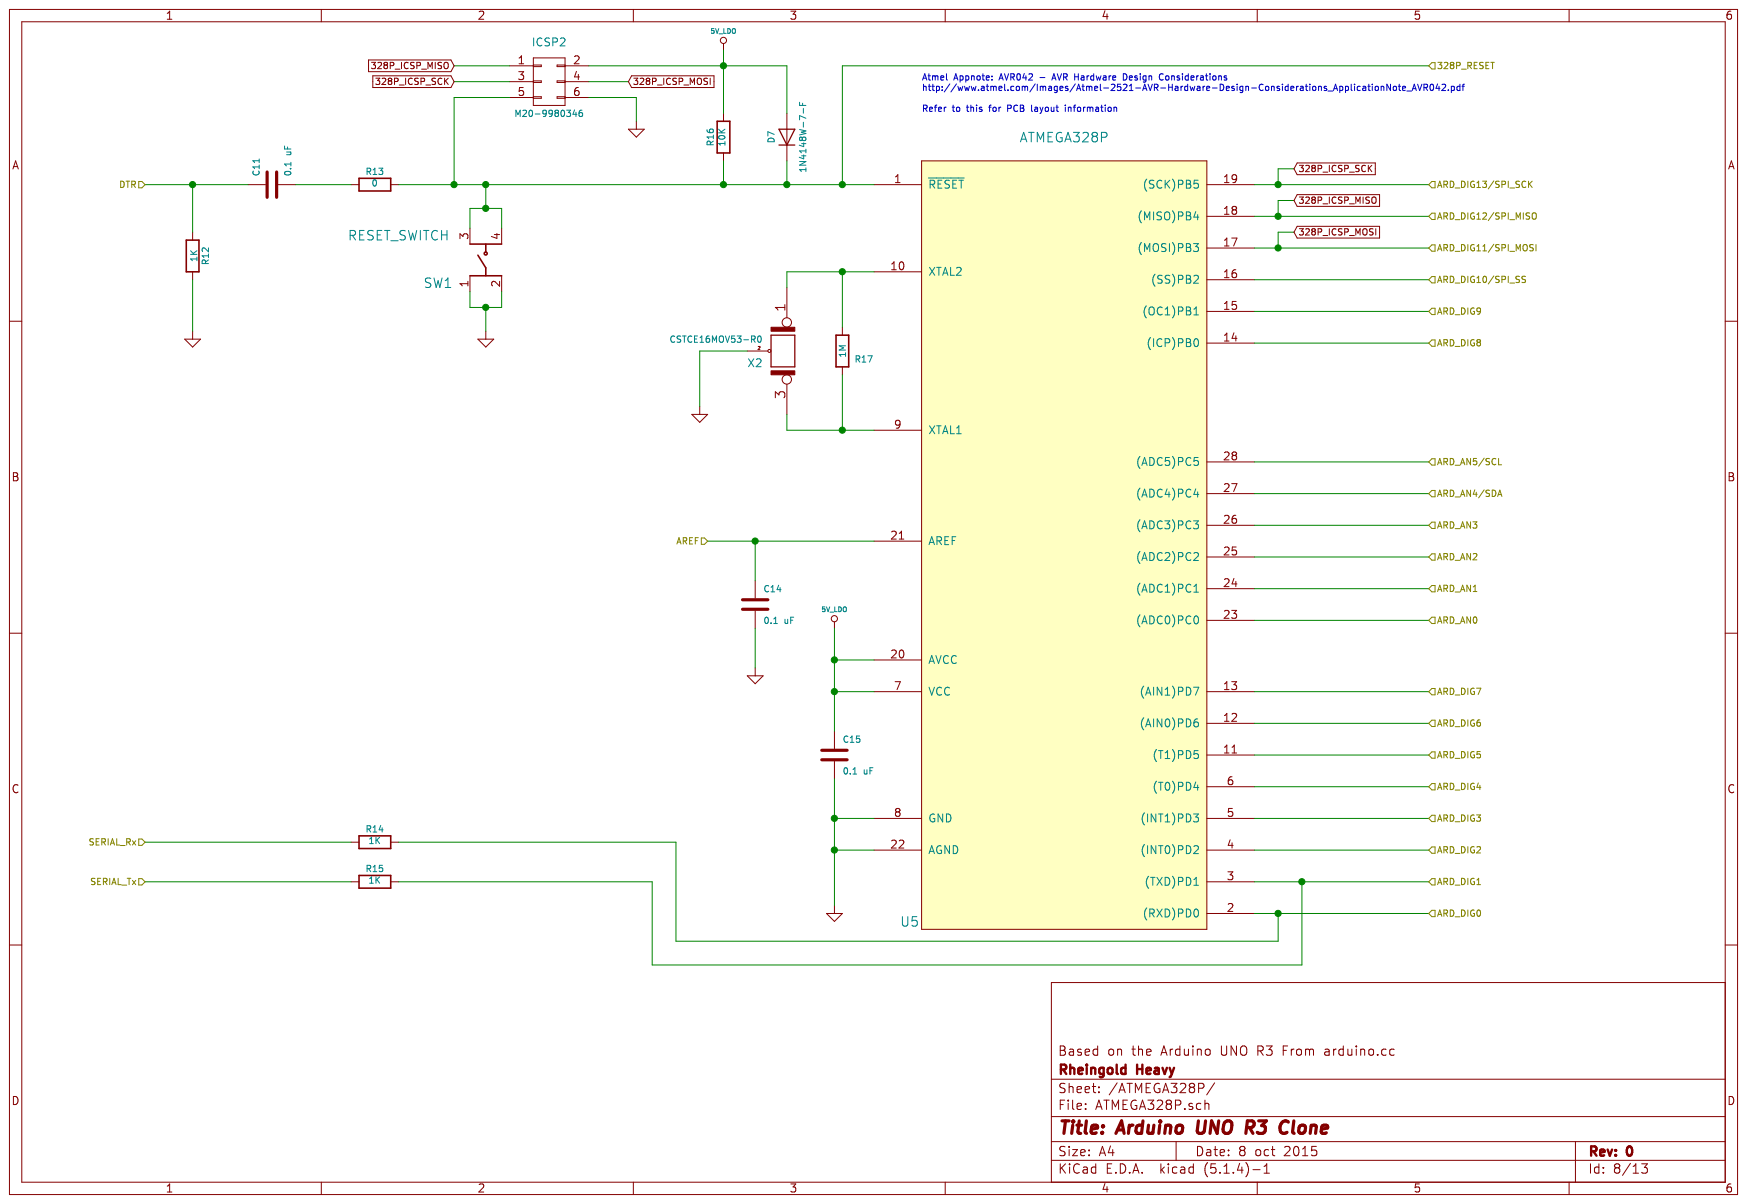
[picture p32: page 8]

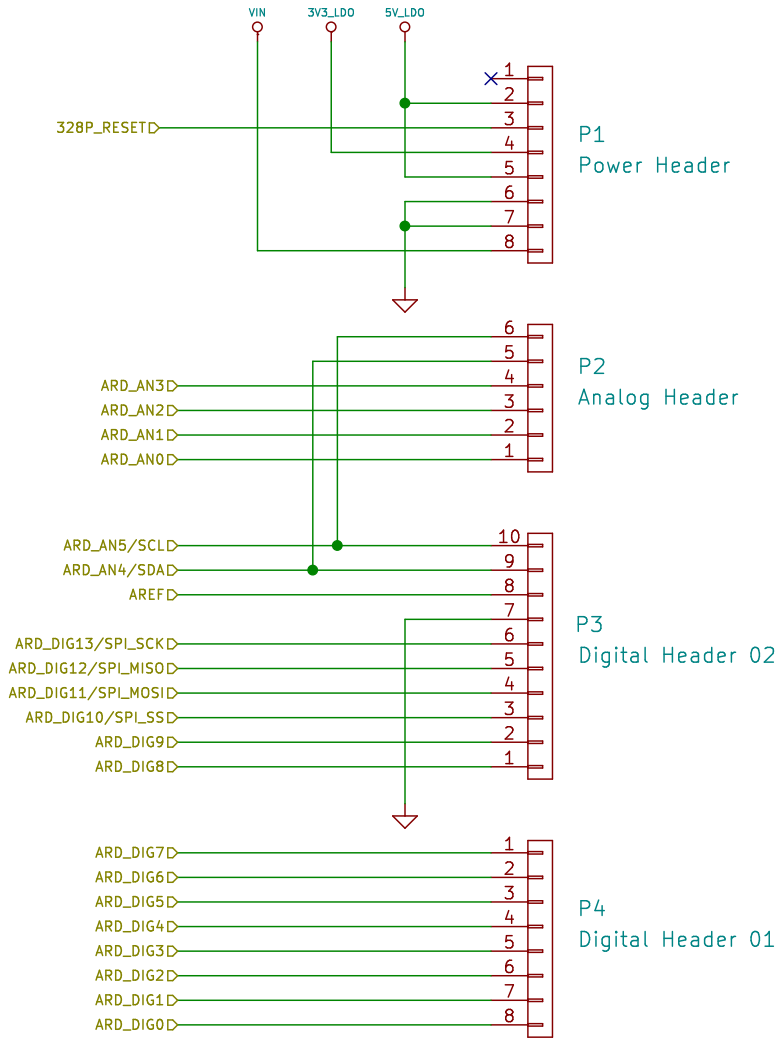
[picture p33: page 9]

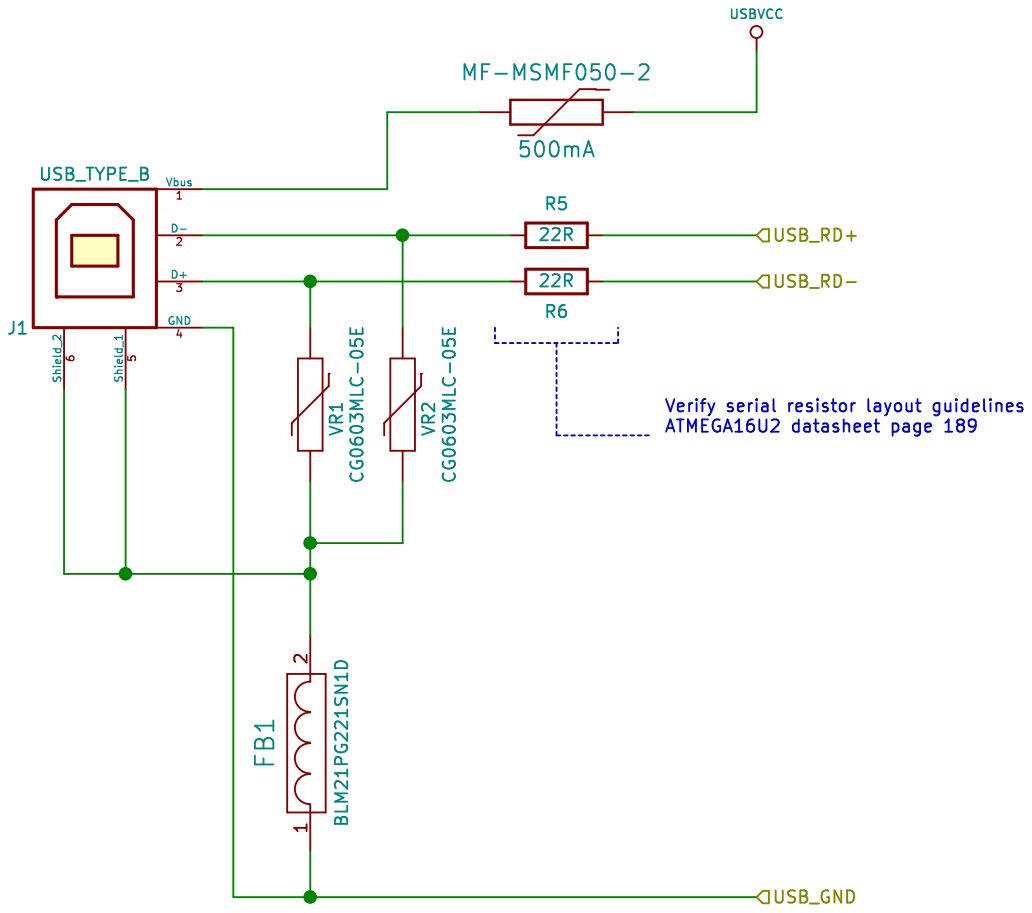
[picture p34: page 10]

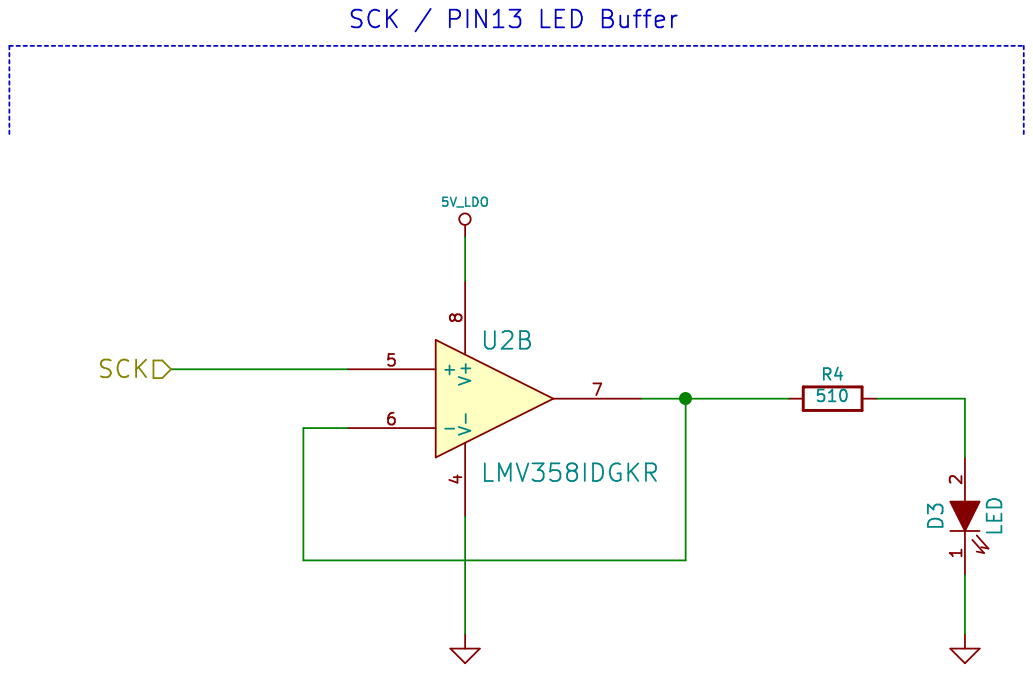
[picture p35: page 11]

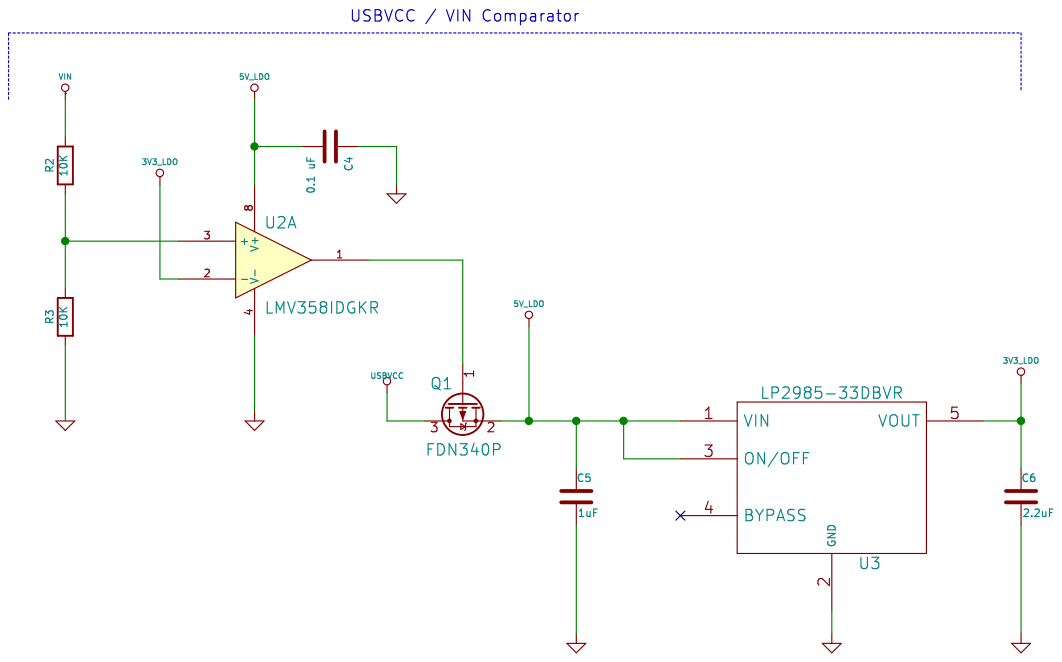
[picture p36: page 12]

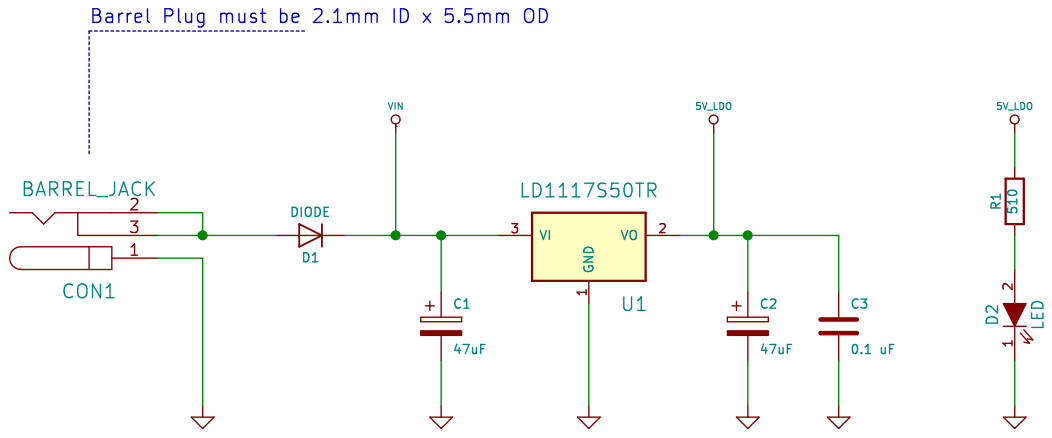
[picture p37: page 13]
