fiuba-labo-de-micro-miercoles/2019-2c-proyecto-Cofimetro/(commit log)

2019-09-30 Anteproyecto -Beta-
    Presentacion preliminar del anteproyecto. Lo que mas falta es buscar como hacer el display.
2019-10-23 Anteproyecto versión 2
    Se incluyen las correcciones en la introducción, el diagrama en bloques y el desarrollo del display.
2019-10-28 División de 4 bytes con 4 bytes con un redondeo simétrico
2019-10-28 Raíz cuadrada de 4 bytes
2019-10-28 Agrego hoja de datos acs_712
2019-10-30 Hoja de Datos del Micro
2019-10-30 Leer tensión desde el pin C (ADC), convertir a corriente y guardar en tabla RAM
2019-11-06 Raiz Cuadrada
    Optimización de código y de ocupación de registros
2019-11-07 Raiz Cuadrada
    Lo más óptima posible antes de optimizarlo completamente
2019-11-07 Desfasaje medido en Timer1
2019-11-08 Desfasaje
    Midiendo entrada de puerto C utilizando Timer 16 Bits e interrupción por puerto C
2019-11-09 Desfasaje
    Compactado para solamente tener que llamar a la función
2019-11-09 Raíz Cuadrada
    Tiempo de cálculo cercano al milisegundo
2019-11-12 Arreglados documentos y modificado lcd.asm, agregado procesar.asm y agregado programa_tp.asm, que seria el main del programa
    [lcd.asm, procesar.asm]
2019-11-13 Borrado Mul_10_Bits
    Se le cambió el nombre y pasó a llamarse "Cuadrado"
2019-11-16 Kicad
    Subo todo el proyecto en kicad. Del esquematico queda poner los pines de conexion del display y el circuito.
    [ACvoltage.sch, ATMEGA16U2-2019-11-09-15-37-54.sch, ATMEGA16U2.sch, ATMEGA328P-2019-11-09-15-37-54.sch, ATMEGA328P.sch, Arduino_Uno_R3_From_Scratch-2019-11-09-15-37-54.sch, Arduino_Uno_R3_From_Scratch.sch, DCcurrent.sch]
2019-11-20 Esquematico_kicad
    Falta poner los pines de muestreo de tension y de corriente y ver que hacemos con los 3 esquematicos vacios de la izquierda.
2019-11-24 Anda la tension
    Ademas raiz 5 iteraciones. Agregado push para sreg
